wzqvip/ESP32S3-SX1262-Meshtatics-Station/Datasheet/module_pics/ATGM336H 5N.png

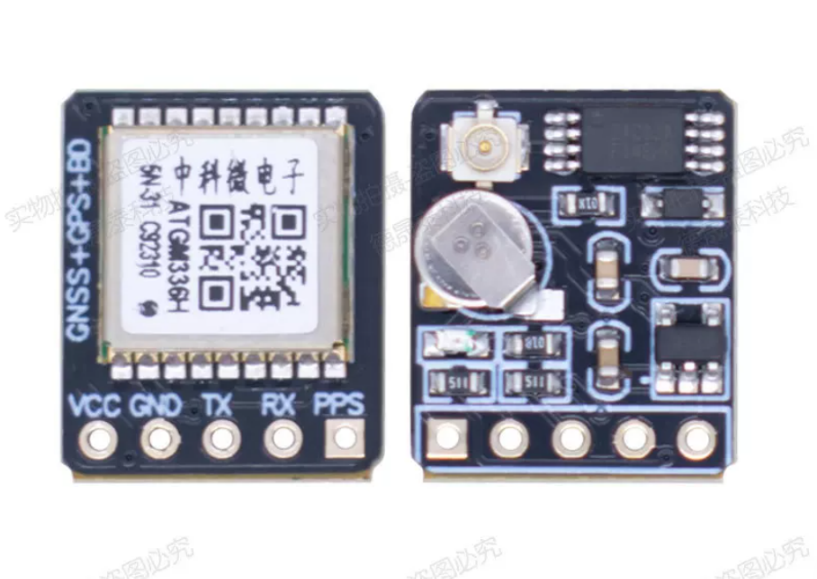
Datasheet/module_pics/ATGM336H 5N.png
