wzqvip/ESP32S3-SX1262-Meshtatics-Station/Datasheet/module_pics/BMI160.webp

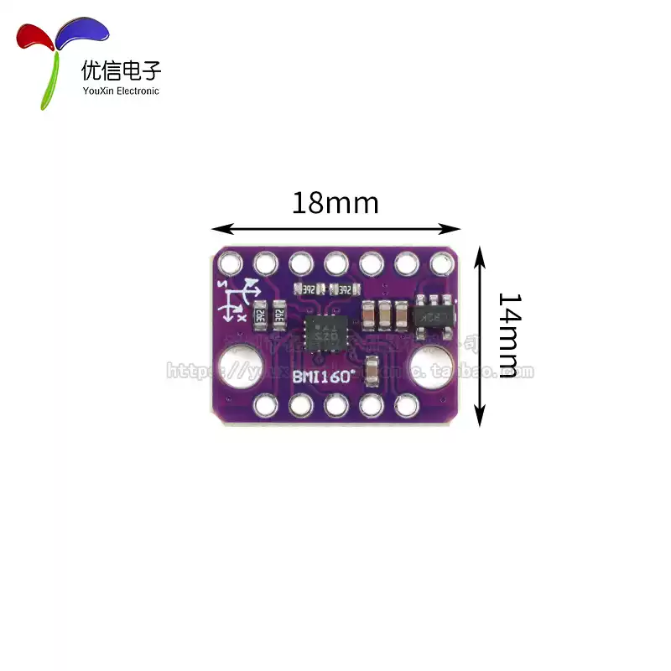
Datasheet/module_pics/BMI160.webp
