wzqvip/ESP32S3-SX1262-Meshtatics-Station/Datasheet/module_pics/DC-DC MP2482 SY8205 5A.webp

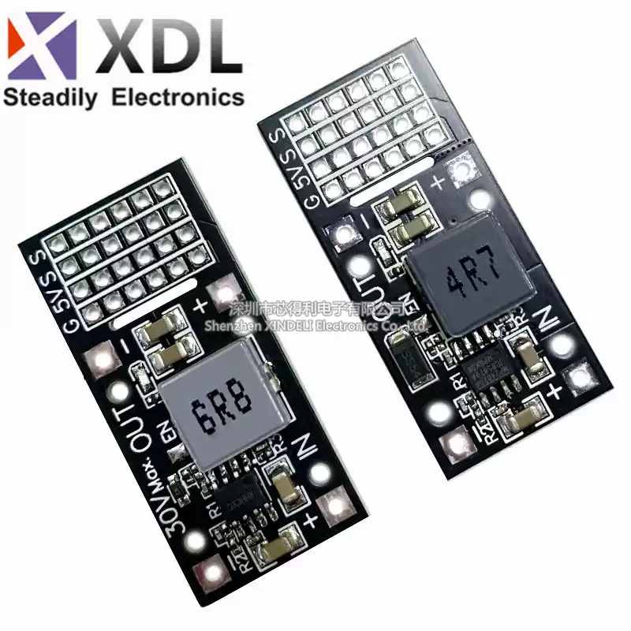
Datasheet/module_pics/DC-DC MP2482 SY8205 5A.webp
