wzqvip/ESP32S3-SX1262-Meshtatics-Station/Datasheet/module_pics/E22-900M30S.webp

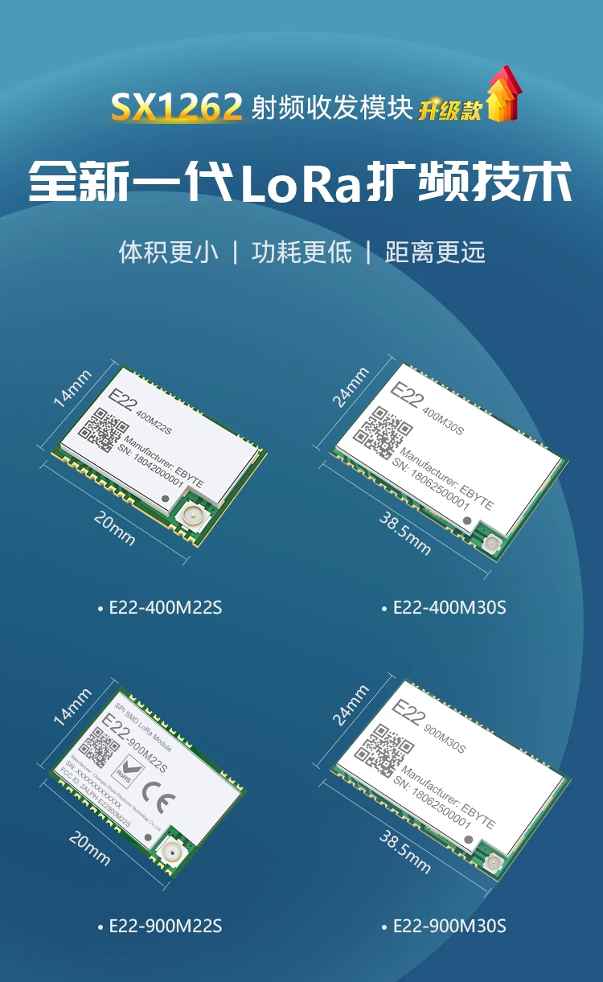
Datasheet/module_pics/E22-900M30S.webp
