wzqvip/ESP32S3-SX1262-Meshtatics-Station/Datasheet/module_pics/ESP32-S3-Pico-details-size.jpg

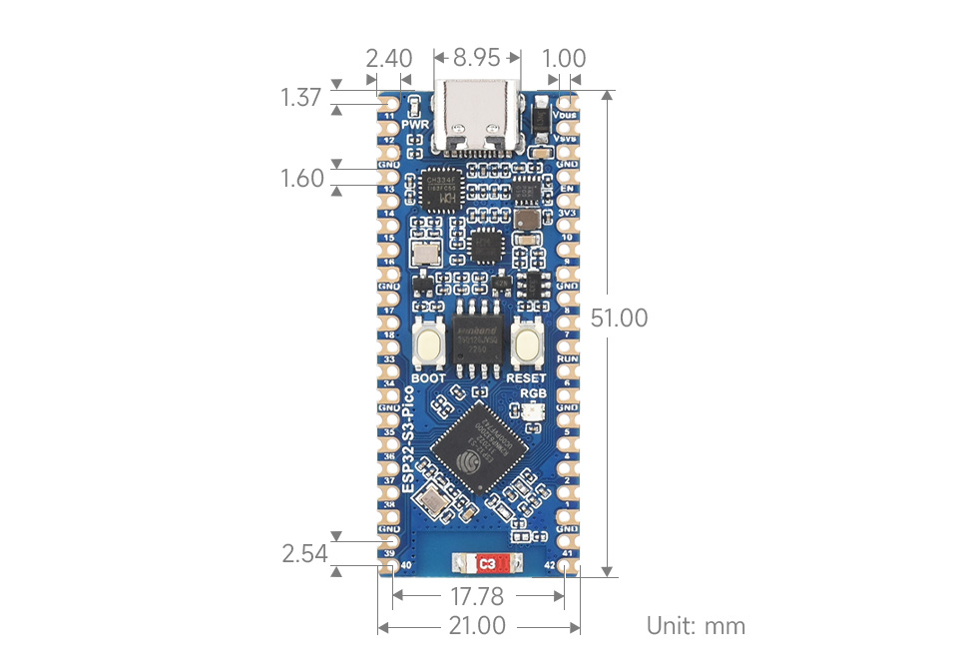
Datasheet/module_pics/ESP32-S3-Pico-details-size.jpg
