wzqvip/ESP32S3-SX1262-Meshtatics-Station/Datasheet/module_pics/OLED_12864.webp

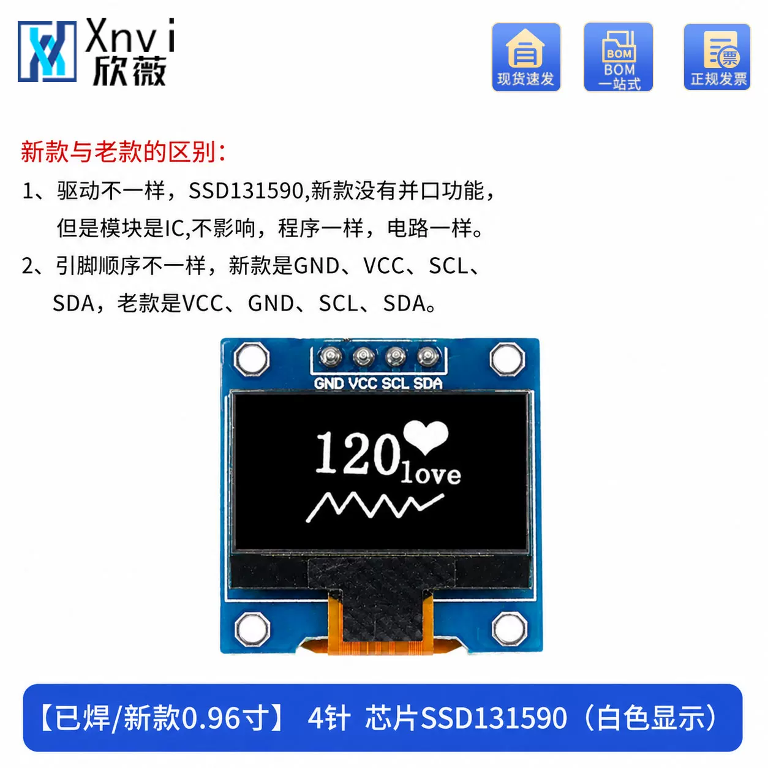
Datasheet/module_pics/OLED_12864.webp
