wzqvip/ESP32S3-SX1262-Meshtatics-Station/Datasheet/module_pics/PCF8563.webp

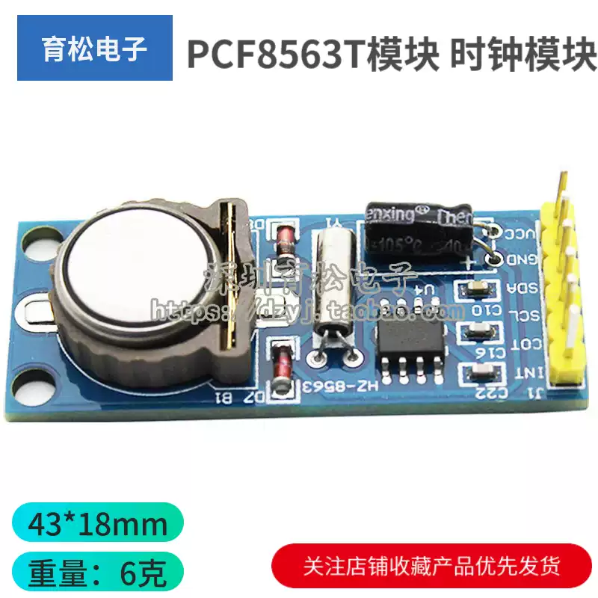
Datasheet/module_pics/PCF8563.webp
