wzqvip/ESP32S3-SX1262-Meshtatics-Station/PD-DC.png

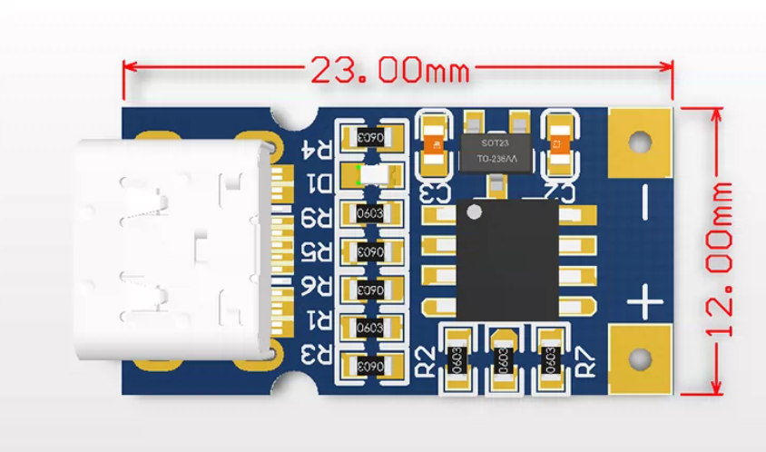
PD-DC.png
