wzqvip/ESP32S3-SX1262-Meshtatics-Station/Review/hardware-schematic/pico-clone-flash-chip.png

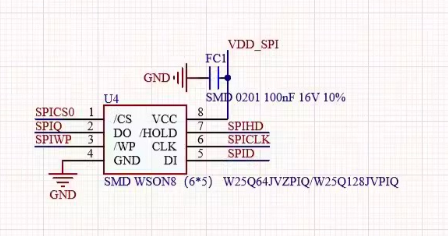
Review/hardware-schematic/pico-clone-flash-chip.png
