wzqvip/ESP32S3-SX1262-Meshtatics-Station/Review/hardware-schematic/pico-clone-full-schematic.jpg

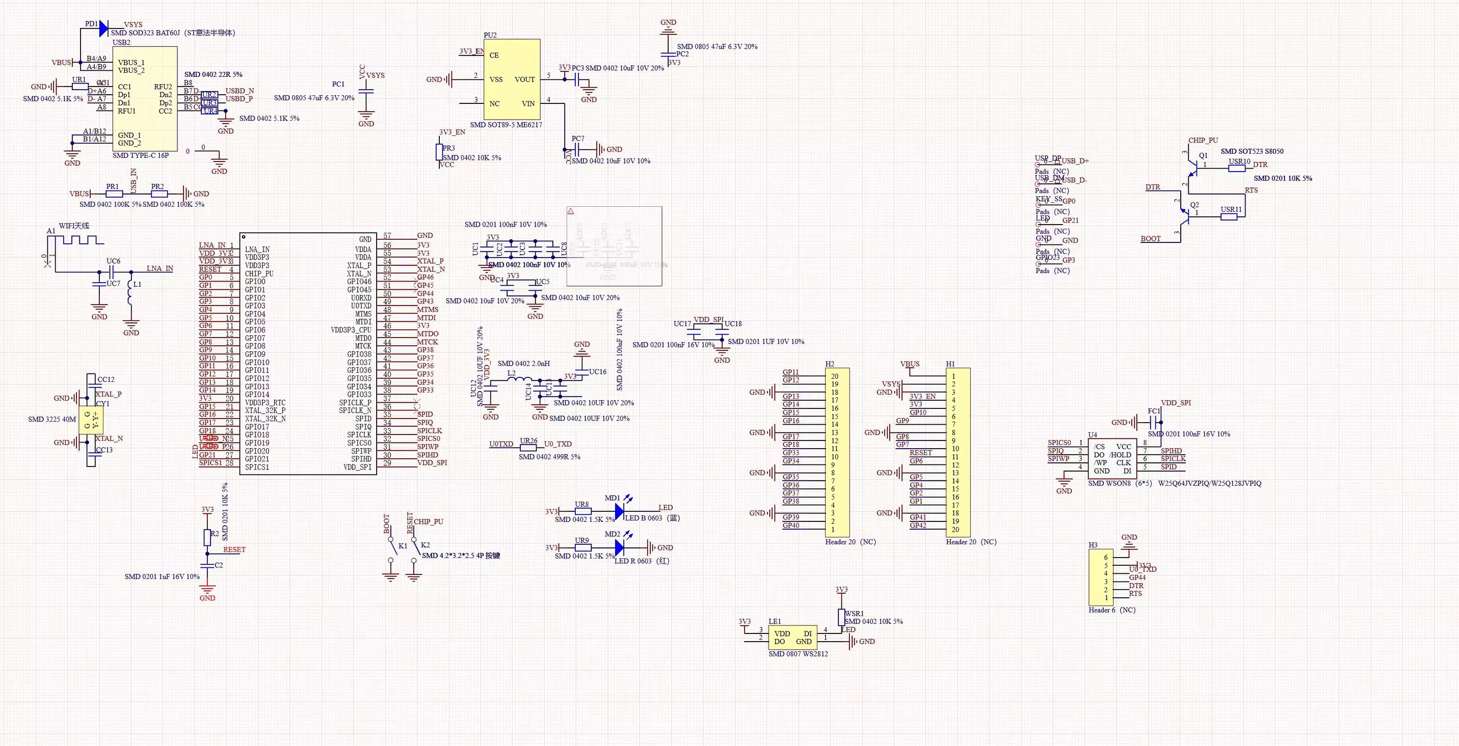
Review/hardware-schematic/pico-clone-full-schematic.jpg
