wzqvip/ESP32S3-SX1262-Meshtatics-Station/PCB/3D_PCB1_1_2026-10-14.step

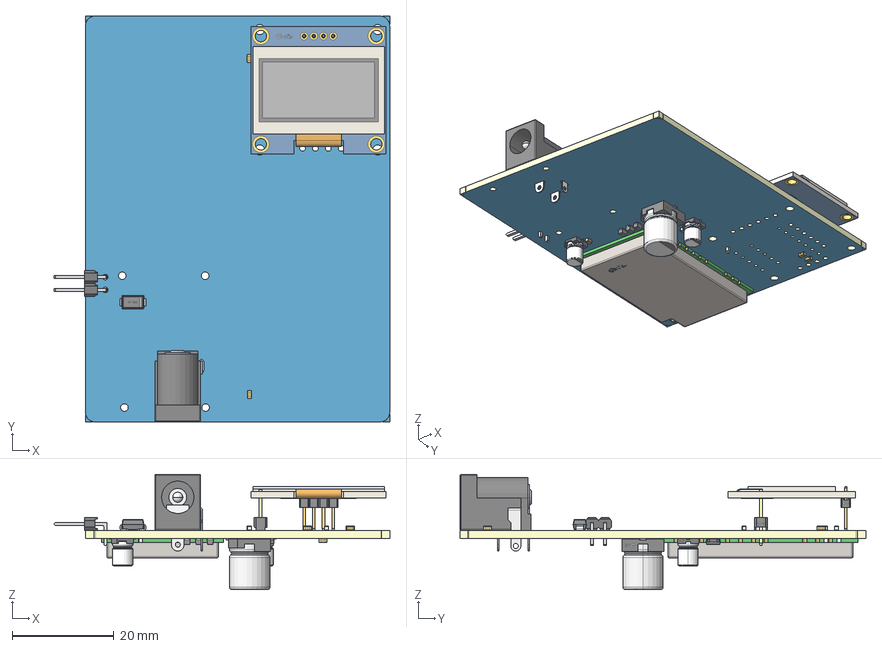
[picture p15: CAD file, 2026-10-14]
PCB/3D_PCB1_1_2026-10-14.step
66.1 x 80.0 x 22.7 mm
Board~G7O5
TopCopper~G7O5
BottomCopper~G7O5
TopSilkscreen~G7O5
BottomSilkscreen~G7O5
TopFpcStiffener~G7O5
BottomFpcStiffener~G7O5
C0603~C0603_L1.6-W0.8-H0.8~G7O5 x 9
SOT-23-5_L3.0-W1.7-P0.95-LS2.8-BR~SOT-23-5_ L2.9-W1.6-H1.1-LS2.8-P0.95~G7O5
DC-IN-TH_DC-005-A200~DC-IN-TH_DC-005-A200~G7O5
SMA_L4.3-W2.6-LS5.0-FD~SMA_L4.3-W2.6-LS5.0-FD~G7O5
CAP-SMD_BD4.0-L4.3-W4.3-LS5.0-FD~CAP-SMD_L4.3-W4.3-H5.3-LS5.1~G7O5 x 2
CAP-SMD_L2.0-W1.3-FD~CAP-SMD_L2.0-W1.3-FD~G7O5 x 3
HDR-TH_2P-P2.54-H-M-W10.0~HDR-TH_2P-P2.54-M-WI-1X2P~G7O5
WIRELM-SMD_E22-900M30S~WIRELM-SMD_L38.5-W24.0-H3.9-E22-900M30S~G7O5
CAP-SMD_BD8.0-L8.3-W8.3-LS9.3-FD~CAP-SMD_BD8.0-L8.3-W8.3-LS9.3-FD~G7O5
OLED 0.96寸~OLED4P~G7O5 x 2
HDR-TH_1P-P2.54-V-M-3~HDR-TH_1P-P2.54-V-M-3~G7O5
