wzqvip/ESP32S3-SX1262-Meshtatics-Station/PCB/SCH_Schematic1_1_2026-10-14.pdf

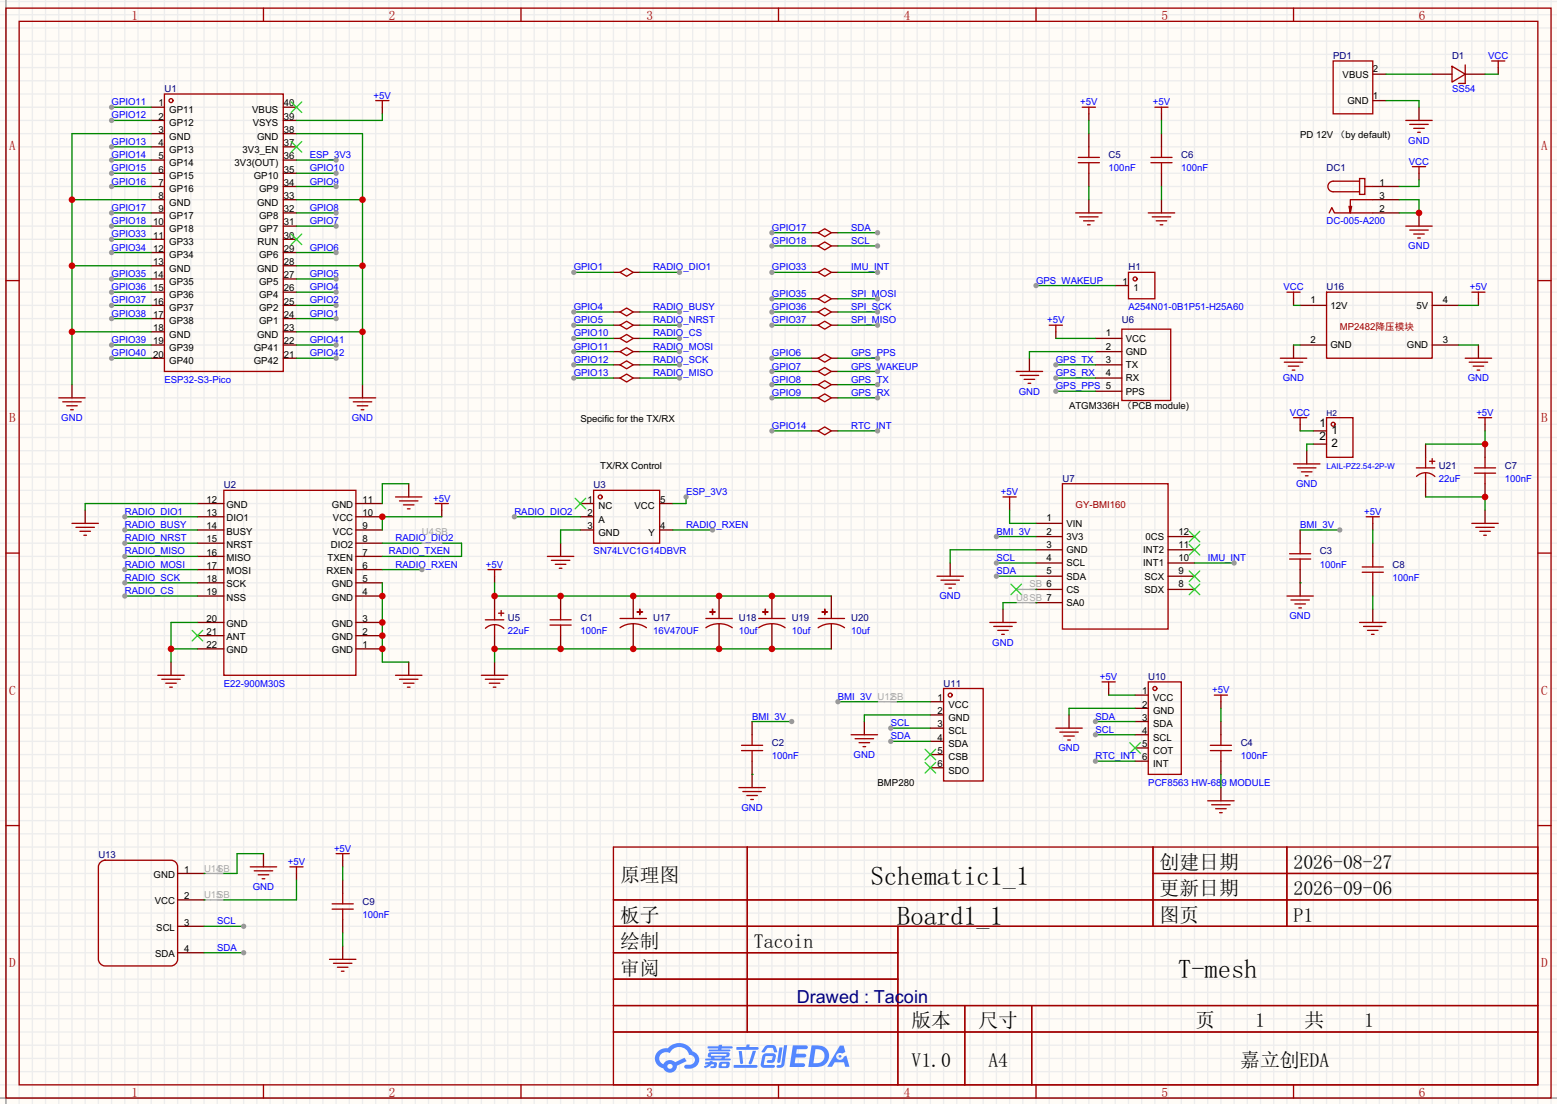
[picture p16: page 1]

PD1 | | D1 | VCC
VBUS 2

GPIO11 | GP11 1 | | +5V | +5V | | | GND 1
GPIO12 | GP12 2

U1 | +5V | | | | | | SS54
GP40 20 GND 8 | GP42 | 21 GP41 22 GND 23 GP1 24 GP2 25 GP4 26 GP5 27 GND 28 GP6 29 RUN 30 GP7 31 GP8 32 GND 33 GP9 34 GP10 35 3V3(OUT) 36 3V3_EN 37 GND 38 VSYS 39 VBUS 40 | | | | | | | 3

GND 3 | | | | PD 12V （by default)

A | GPIO13 | GP13 4 | | | | | | | | | | GND | | A

GPIO14 | GP14 5 | | | ESP_3V3 | | | C5 | C6 | | | | VCC
GPIO15 | GP15 6 | | | GPIO10 | | | 100nF | 100nF | DC1
GPIO16 | GP16 7 | | | GPIO9 | | | | | | 1

GPIO17 | GP17 9 | | | GPIO8 | | | | | | 2
GPIO18 | GP18 10 | | | GPIO7 | GPIO17 | SDA | | | DC-005-A200
GPIO33 | GP33 11
GPIO34 | GP34 12 | | | GPIO6 | GPIO18 | SCL | | | | | | GND

GND 13 | | GPIO1 | RADIO_DIO1 | GPIO33 | IMU_INT | | | | H1

GPIO35 | GP35 14 | GPIO5 | | | | | GPS_WAKEUP
GPIO36 | GP36 15 | GPIO4 | | | GPIO35 | SPI_MOSI | | | 1 | 1 | VCC | U16 | | | | | +5V
GPIO37 | GP37 16 | GPIO2 | | | | | | | | | | 12V 1 | | | 5V | 4
GPIO38 | GP38 17 | GPIO1 | GPIO4 | RADIO_BUSY RADIO_NRST | GPIO36 | SPI_SCK | | +5V | U6 | A254N01-0B1P51-H25A60

GPIO5 | | GPIO37 | SPI_MISO
GPIO10 | RADIO_CS
GPIO11
GPIO12 | RADIO_SCK

GPIO39 | GP39 19 | GPIO41 | | RADIO_MOSI | | | | | | VCC 1 | | GND 2 | | GND | | 3
GPIO40 | | GPIO42 | | | GPIO6 | GPS_PPS | | GPS_TX | | GND 2

GND 18 | | | | | | | | | | | | MP2482降压模块

GPIO7 | GPS_WAKEUP | | | | TX 3

ESP32-S3-Pico | | GPIO13 | RADIO_MISO | GPIO8 | GPS_TX | | GPS_RX GPS_PPS | | RX 4 | GND | | | | | | GND

GPIO9 | GPS_RX | GND | | PPS 5

ATGM336H （PCB module) | | VCC | | | | +5V

B | GND | GND | | GPIO14 Specific for the TX/RX | RTC_INT | | | | | 1 | H2 | | | | B

TX/RX Control | | | | | | | | | U21 | | C7

U7 | | | LAIL-PZ2.54-2P-W | | 22uF | 100nF

U2 | | | | | | U3 | | | | ESP_3V3 | +5V | | | GND
GND | | 11 GND 12 | +5V | | | NC 1 | VCC | 5

RADIO_DIO1 | DIO1 13 | | VCC | 10 | | RADIO_DIO2 | 2 | | | | | | | GY-BMI160 | | | +5V

RADIO_NRST | | NRST 15 | | DIO2 | | 8 | RADIO_DIO2 | | | | | | | Y | | | | | | | | | | | 3V3 2 | 0CS | 12
RADIO_MISO | | MISO 16 | | TXEN | | 7 | RADIO_TXEN | | | | | SN74LVC1G14DBVR | | | | | | | | | | | | | GND 3 | INT2 | 11 | IMU_INT | | C3
RADIO_MOSI | | MOSI 17 | | RXEN | | 6 | RADIO_RXEN | +5V | | | | | | | | | | | | | | | | | SCL 4 | INT1 | 10 | | | 100nF | C8
RADIO_SCK | | SCK 18 | | GND | | 5 | | | | | | | | | | | | | | | | | SDA | | SDA 5 | SCX | 9 | | | | 100nF
RADIO_CS | | NSS 19 | | GND | | 4 | | | | | | | | | | | | | | | | GND | | | CS 6 | SDX | 8

SCL

SB
SA0 7

GND 20 | | GND | | 3 | | | U5 | | C1 | | | | U17 | | U18 | | U19 | | U20 | | | | | | | | GND
ANT 21 | | GND | | 2 | | | 22uF | | 100nF | | | 16V470UF | | | 10uf | | 10uf | | 10uf
GND 22 | | GND | | 1 | | | | | | | | | | | | | | | | | GND

BMI_3V | | U12SB | | VCC 1 | | | | VCC 1

BMI_3V | | | | | | GND 2 | | | | GND 2

SDA

C2 | | | | SDA | SDA 4 | | | | SCL 4 | | C4
100nF | | GND | | | CSB 5 | GND | RTC_INT | | COT 5 | | 100nF

SCL | SCL 3 | | SCL | | SDA 3

SDO 6 | | | | INT 6

BMP280 | | | | | PCF8563 HW-689 MODULE

U13 | | | | | +5V
GND | 1 | U14SB | | | | 原理图 | Schematic1_1 | 创建日期 | 2026-08-27

GND | | | | | 更新日期 | 2026-09-06

VCC | 2 | U15SB

C9 100nF | 板子 | | Board1_1 | 图页 | P1

SCL | 3 | | SCL

绘制 | Tacoin

SDA | 4 | SDA

D | | | | 审阅 | T-mesh | D

Drawed : Tacoin
