wzqvip/ESP32S3-SX1262-Meshtatics-Station/PCB/SCH_Schematic1_1_2026-09-06.pdf

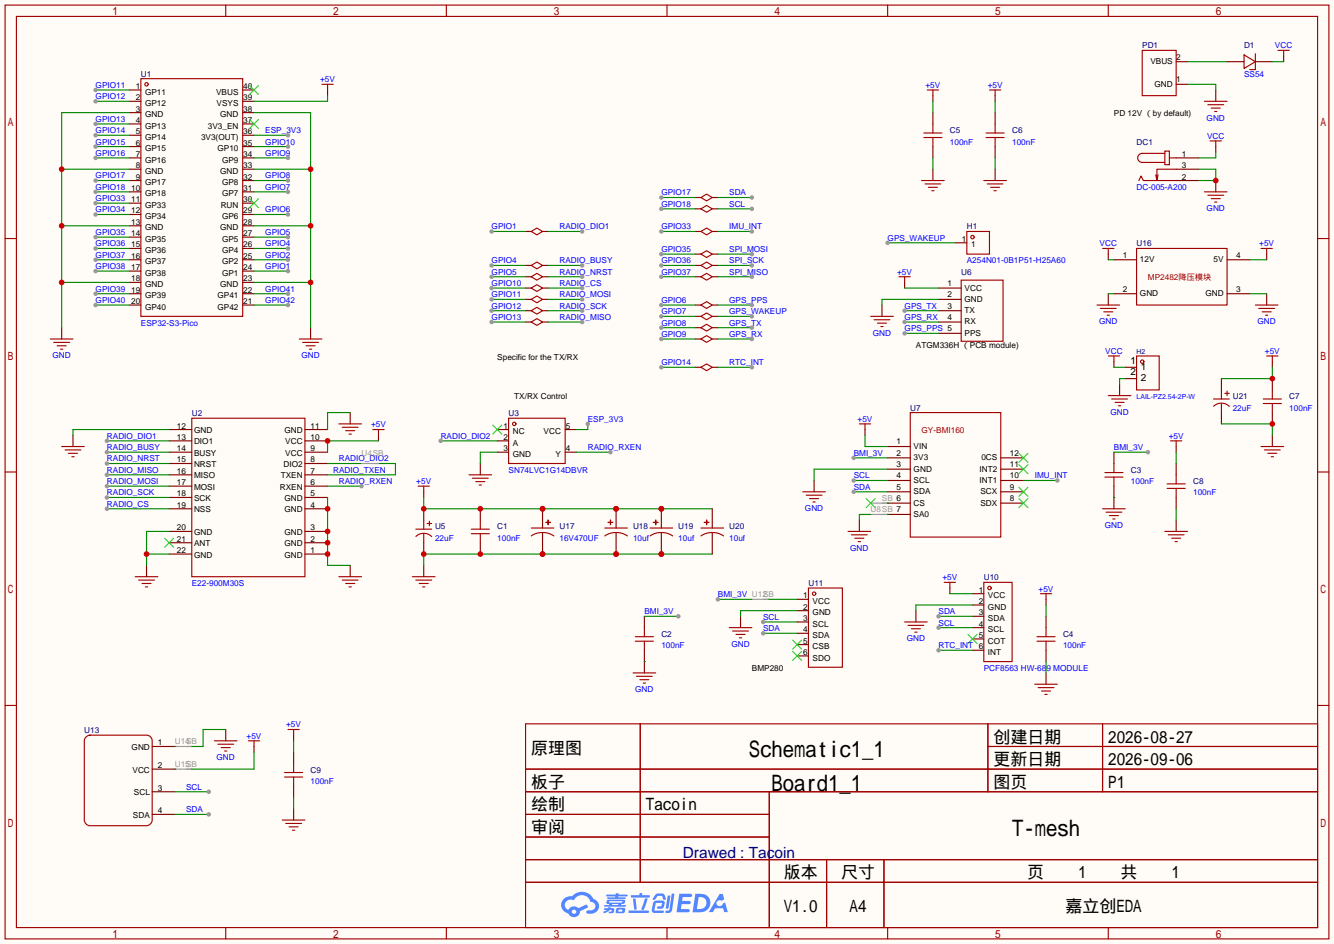
[picture p17: page 1]

GPIO14 Specific for the TX/RX

原理图 | Schematic1_1 | 创建日期 | 2026-08-27
板子 | Board1_1 | 图页 | P1
绘制 | Tacoin | T-mesh
审阅

更新日期 | 2026-09-06

Drawed : Tacoin

V1.0 | A4 | 嘉立创EDA
