wzqvip/ESP32S3-SX1262-Meshtatics-Station/nano_g1_explorer_06_mar_2023.pdf

Battery Charger | Buck-Boost Converter 100k R8 100k R9 GND | BAT_ADC BAT

# Type C / Battery

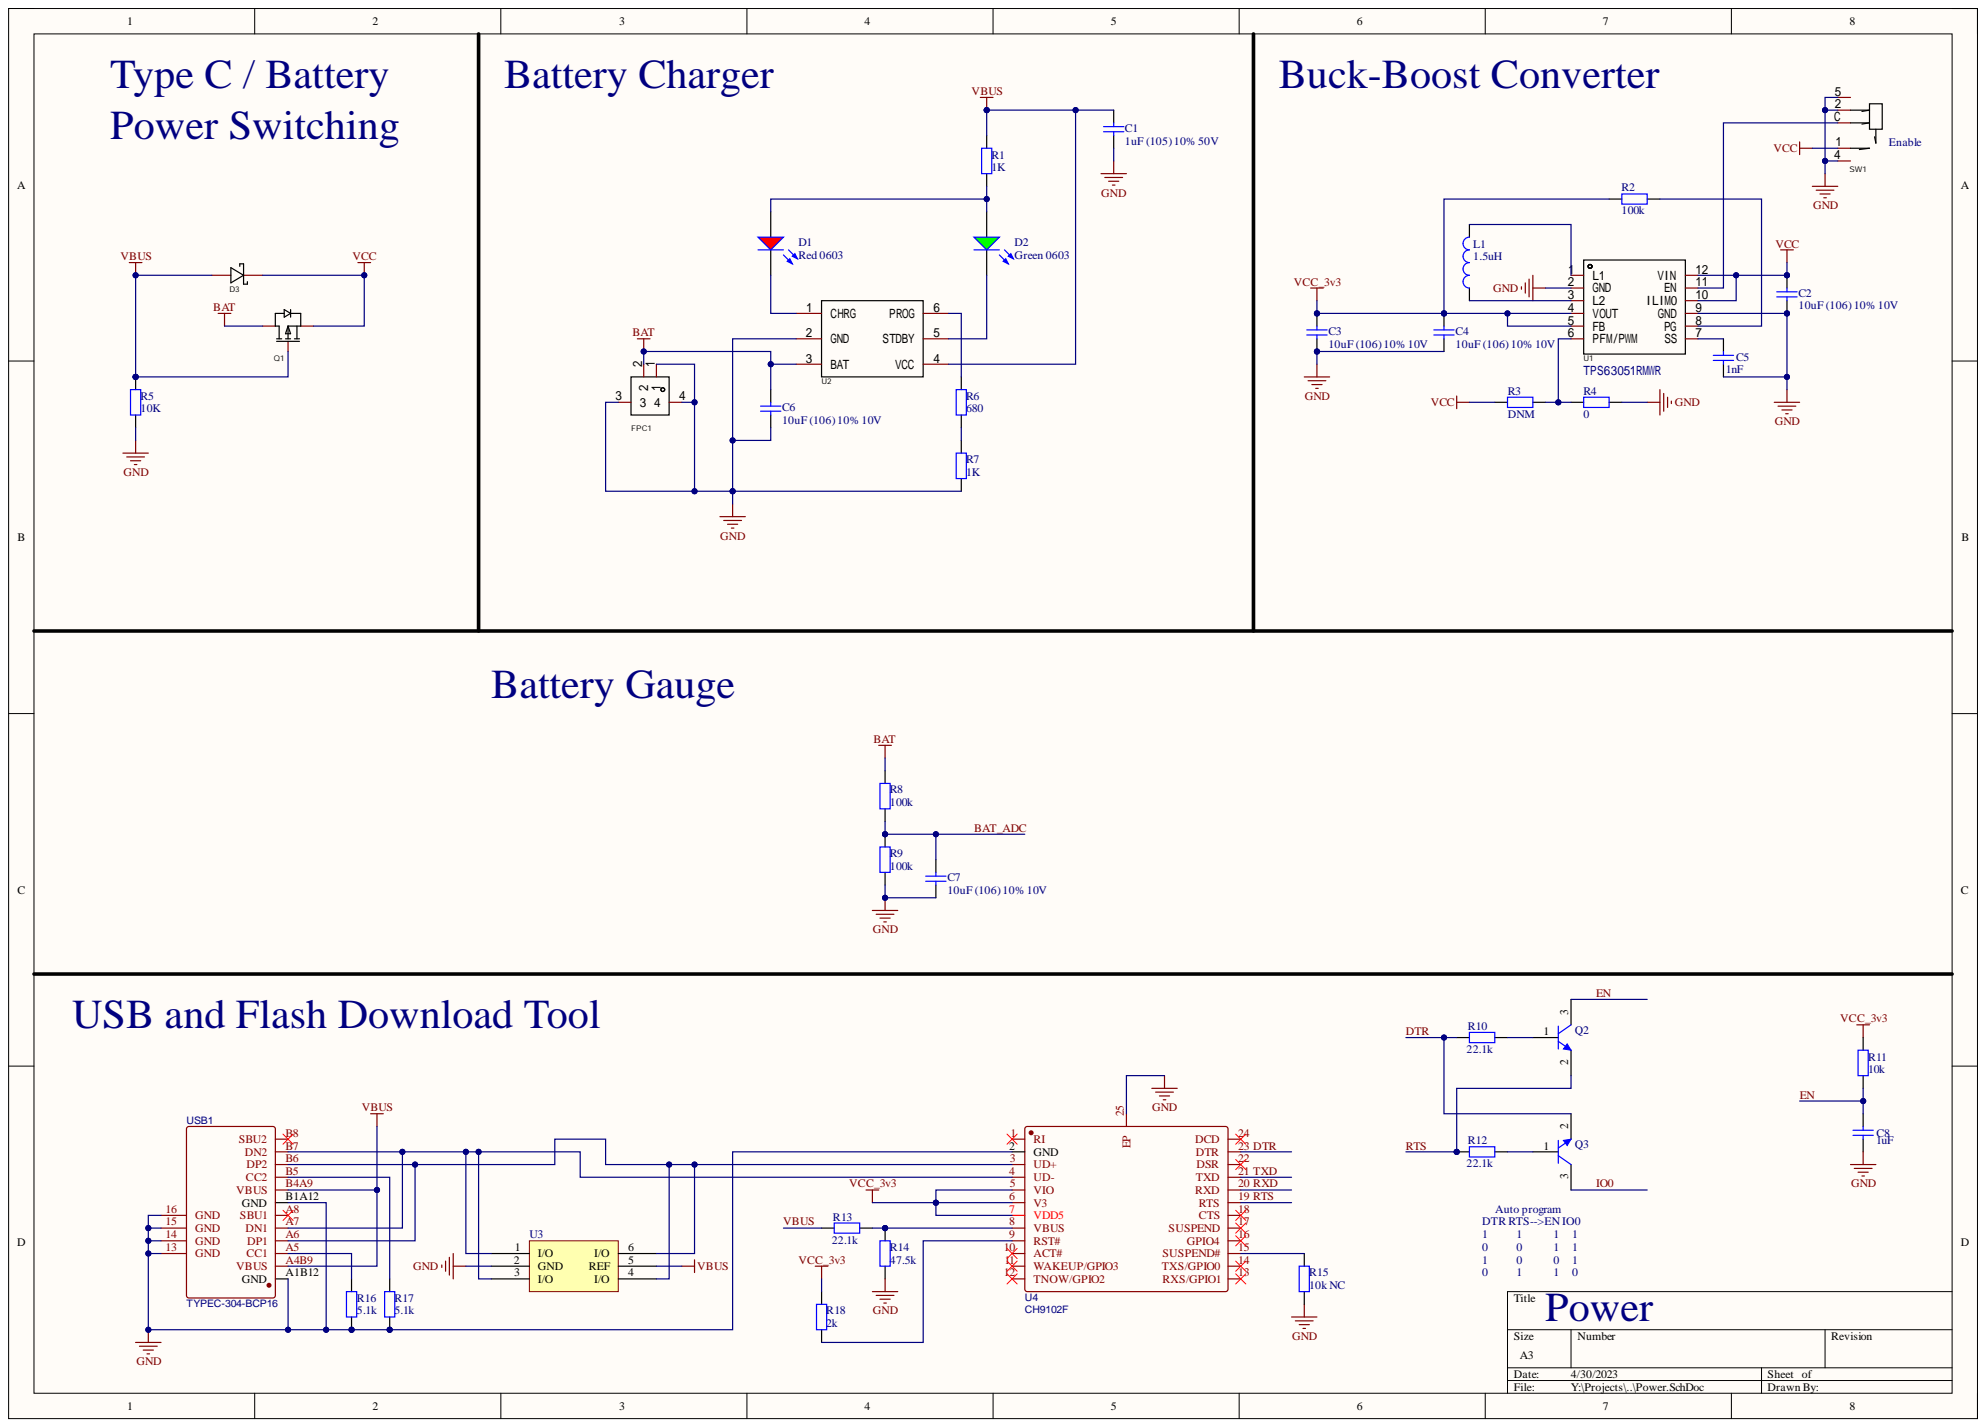
[picture p18: page 1]
ENIO0; XD RXD RTS; END; PEND; Tool; Power Switching; Battery Gauge; Power

USB and Flash Download

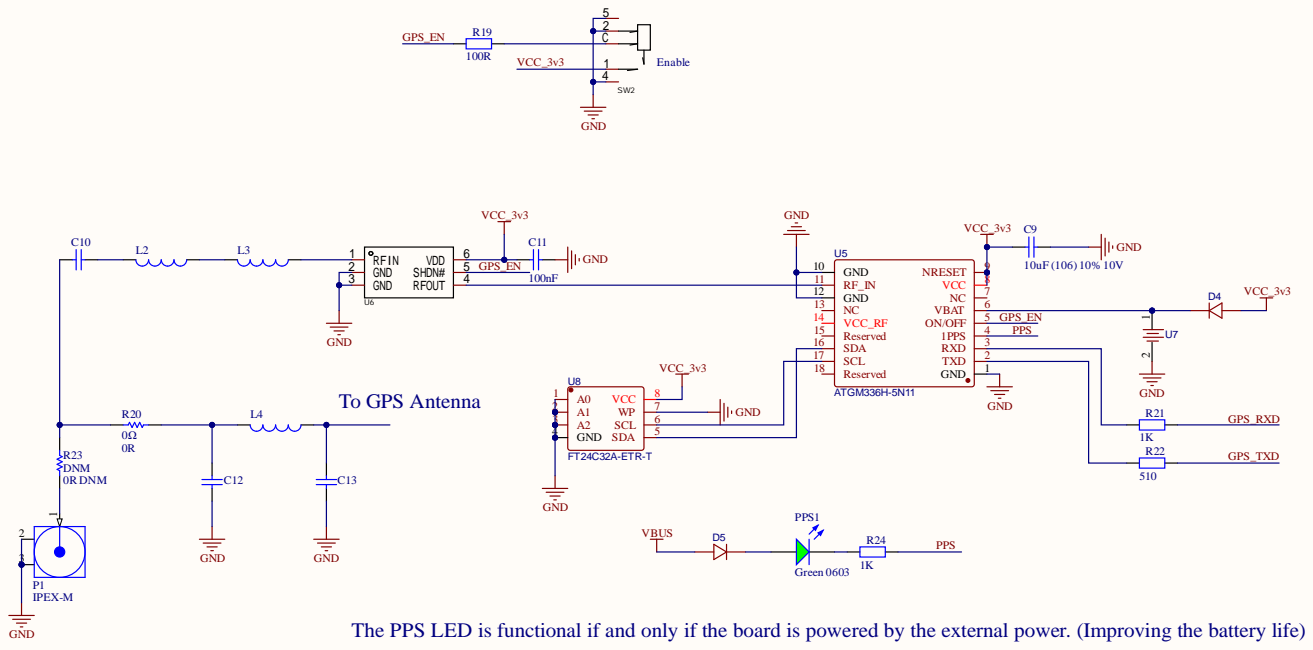
[picture p19: page 2]

The PPS LED is functional if and only if the board is powered by the external power. (Improving the battery life)

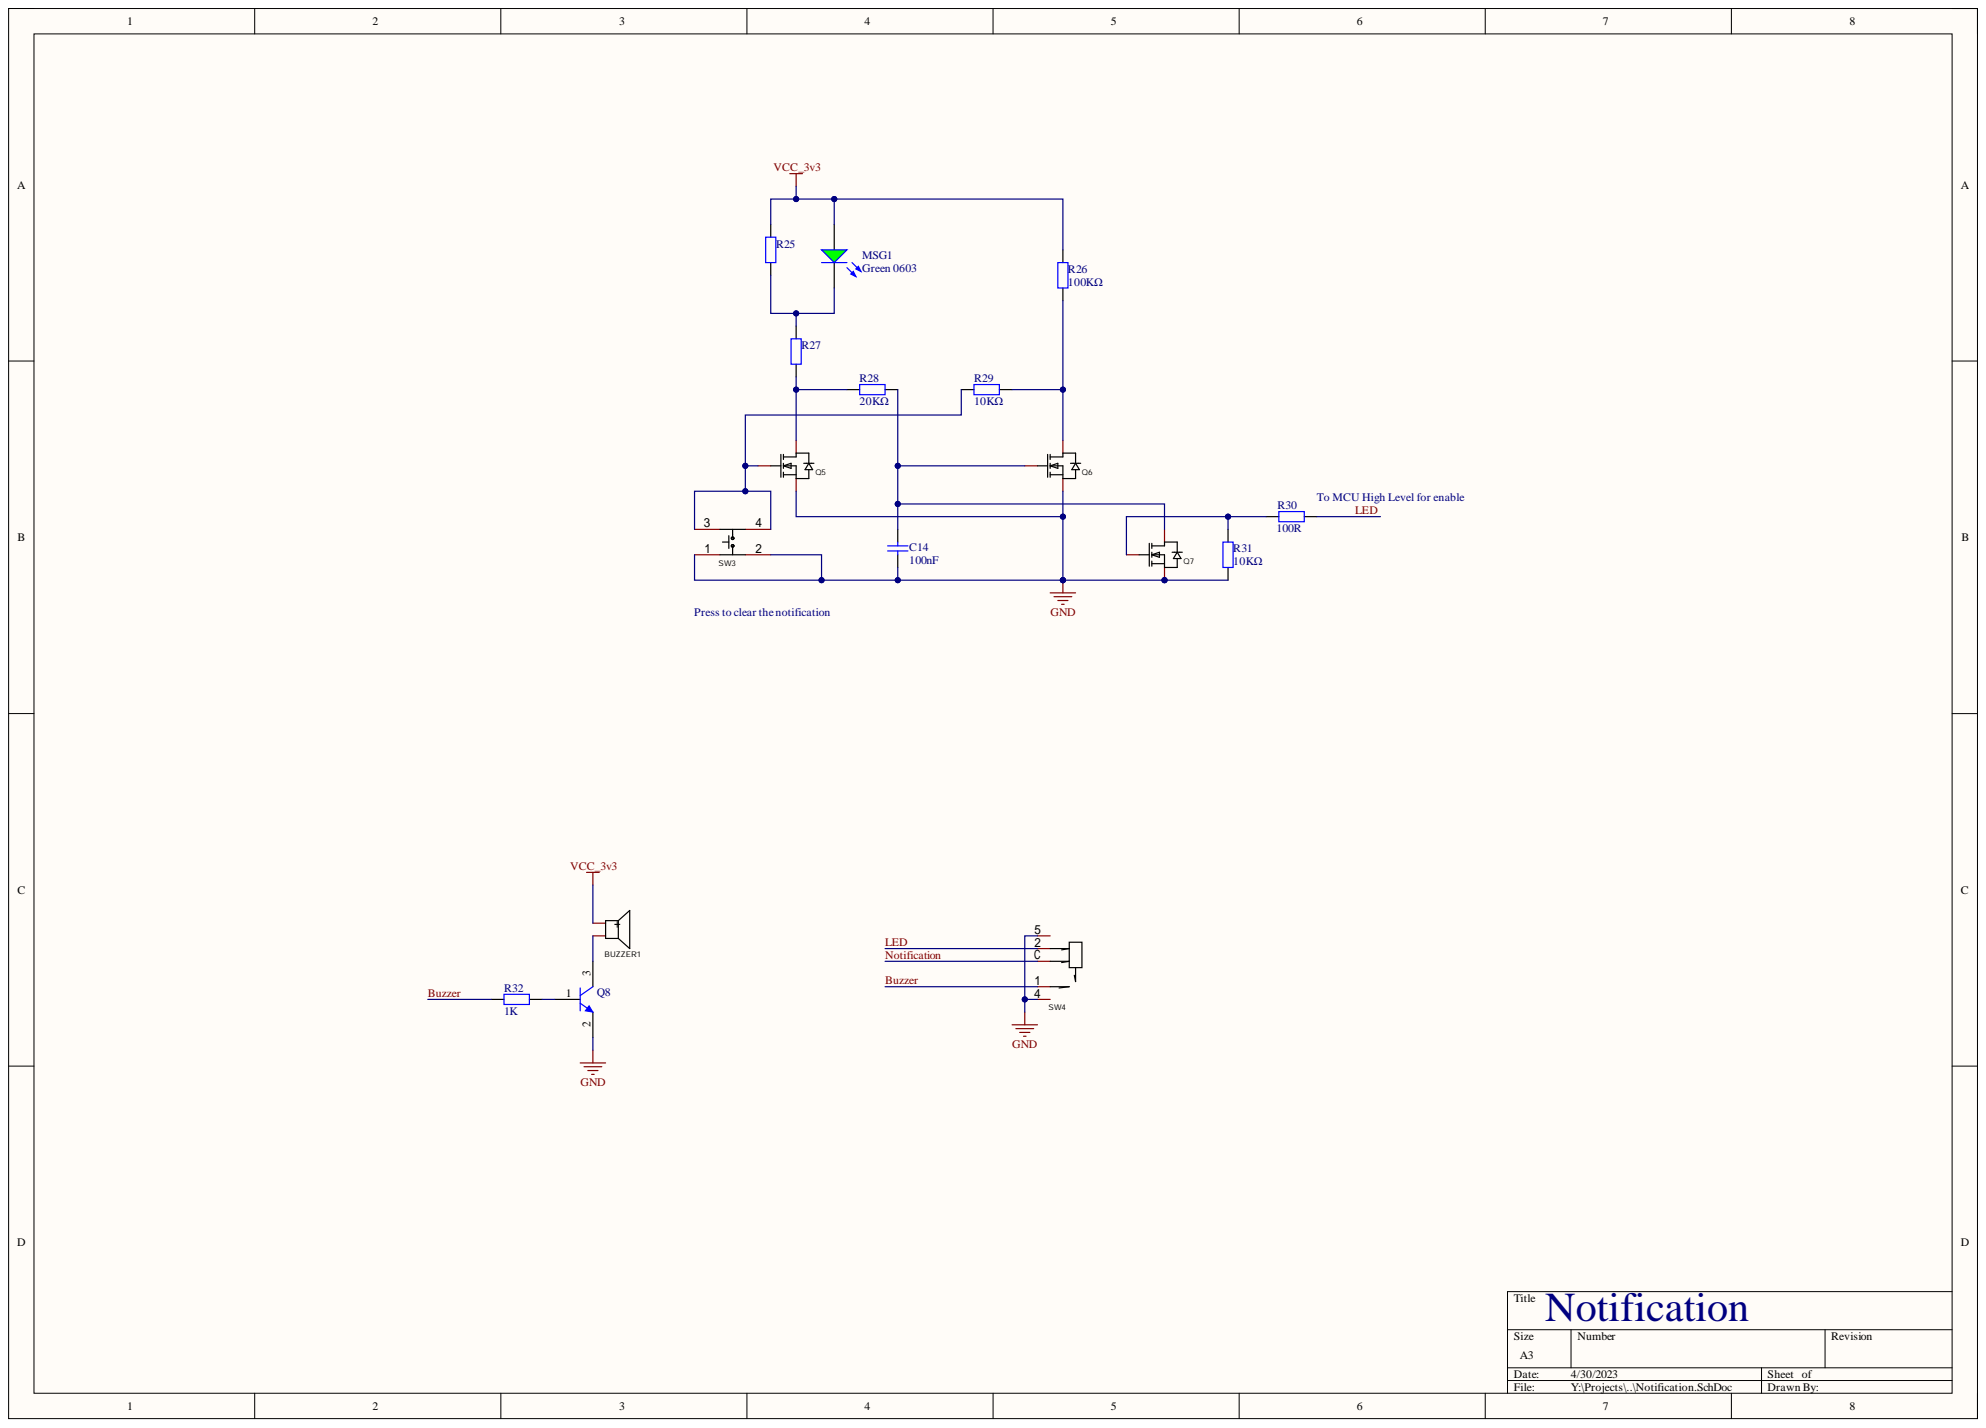
[picture p20: page 3]

To MCU High Level for enable

Pressto clear the notification

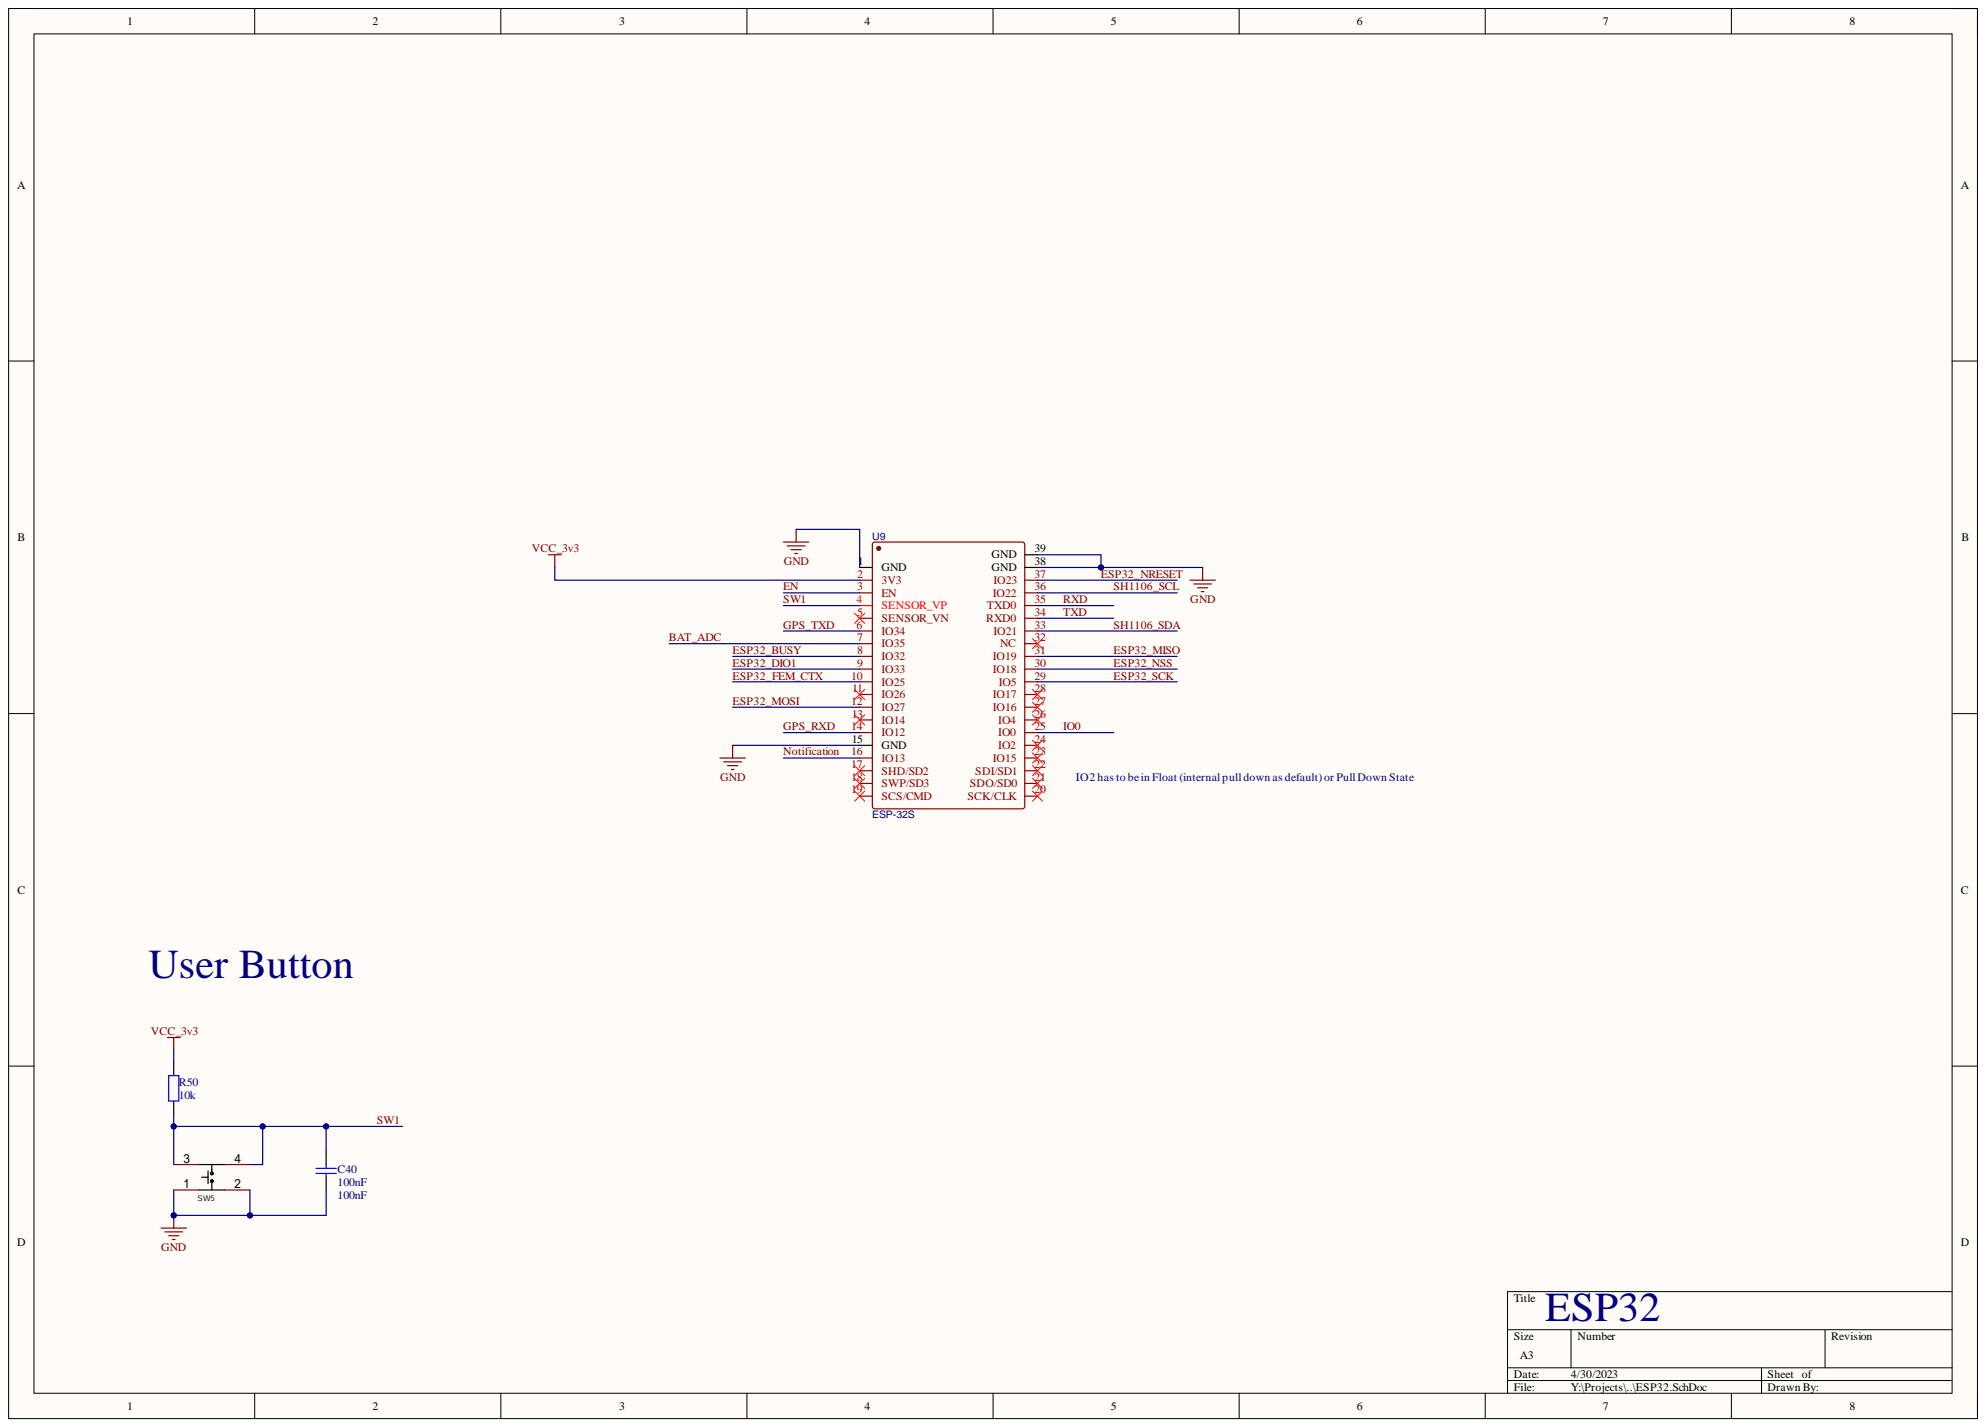
[picture p21: page 4]
Title; Size; Number; Revision; File:; Y:\Projects\..\ESP32.SchDoc; Drawn By:; GND 1 3V3 2 EN 3 SENSOR_VP 4 SENSOR_VN 5 IO34 6 IO35 7 IO32 8 IO33 9 IO25 10 IO26 11 IO27 12 IO14 13 IO12 14 GND 15 IO13 16 SHD/SD2 17 SWP/SD3 18; SCS/CMD 19; SCK/CLK; 20 SDO/SD0; 21 SDI/SD1; 33 RXD0; 34 TXD0; 37 GND; 38 GND; ESP-32S; TXD; RXD; GND; VCC_3v3; SH1106_SDA; SH1106_SCL; Notification; GPS_RXD; GPS_TXD; BAT_ADC; ESP32_MOSI; ESP32_FEM_CTX; ESP32_DIO1; ESP32_BUSY; User Button; ESP32_SCK; ESP32_NSS; ESP32_MISO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

IO2 hasto be in Float (internal pull down as default) or PullDown State

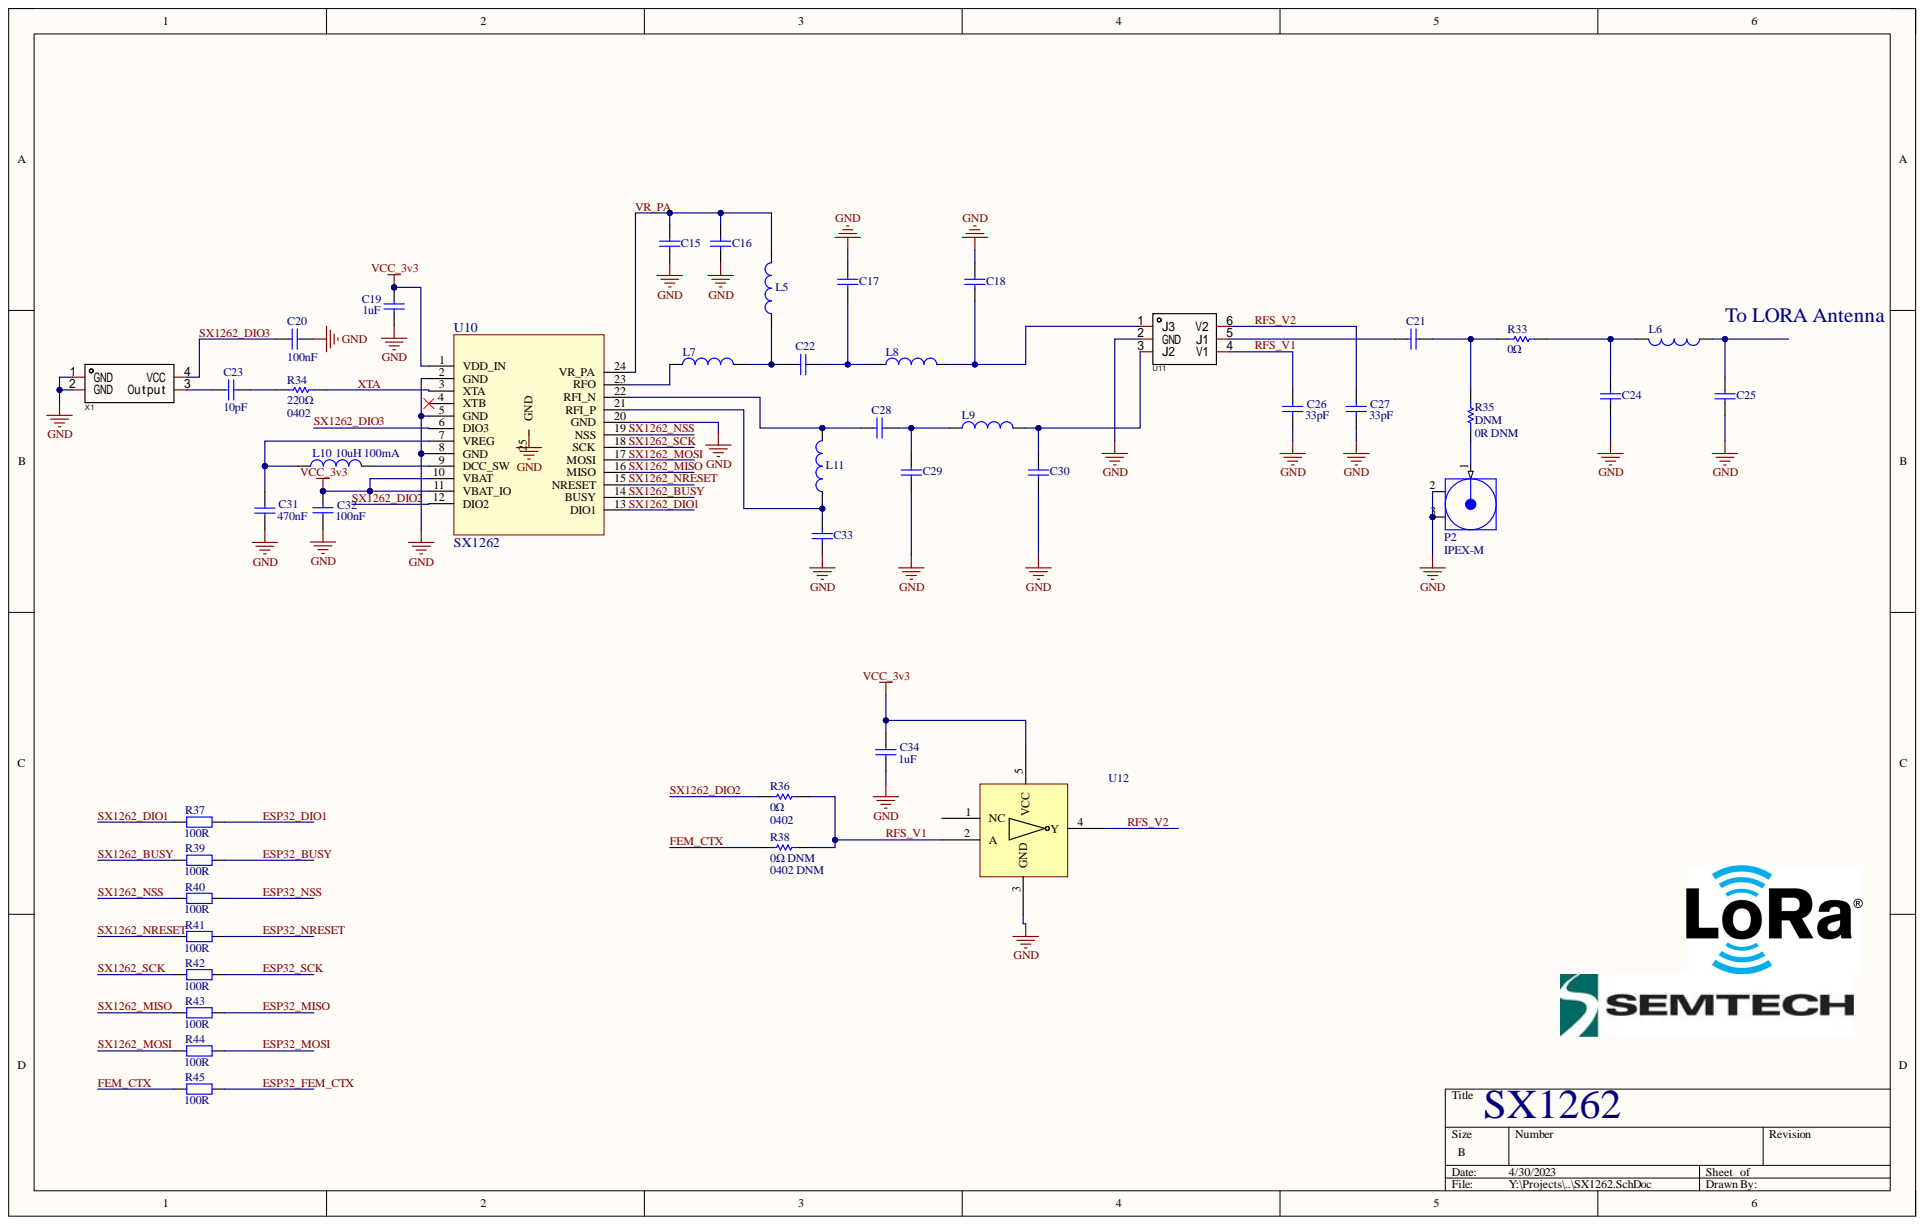
[picture p22: page 5]

A | A

## VCC_3v3

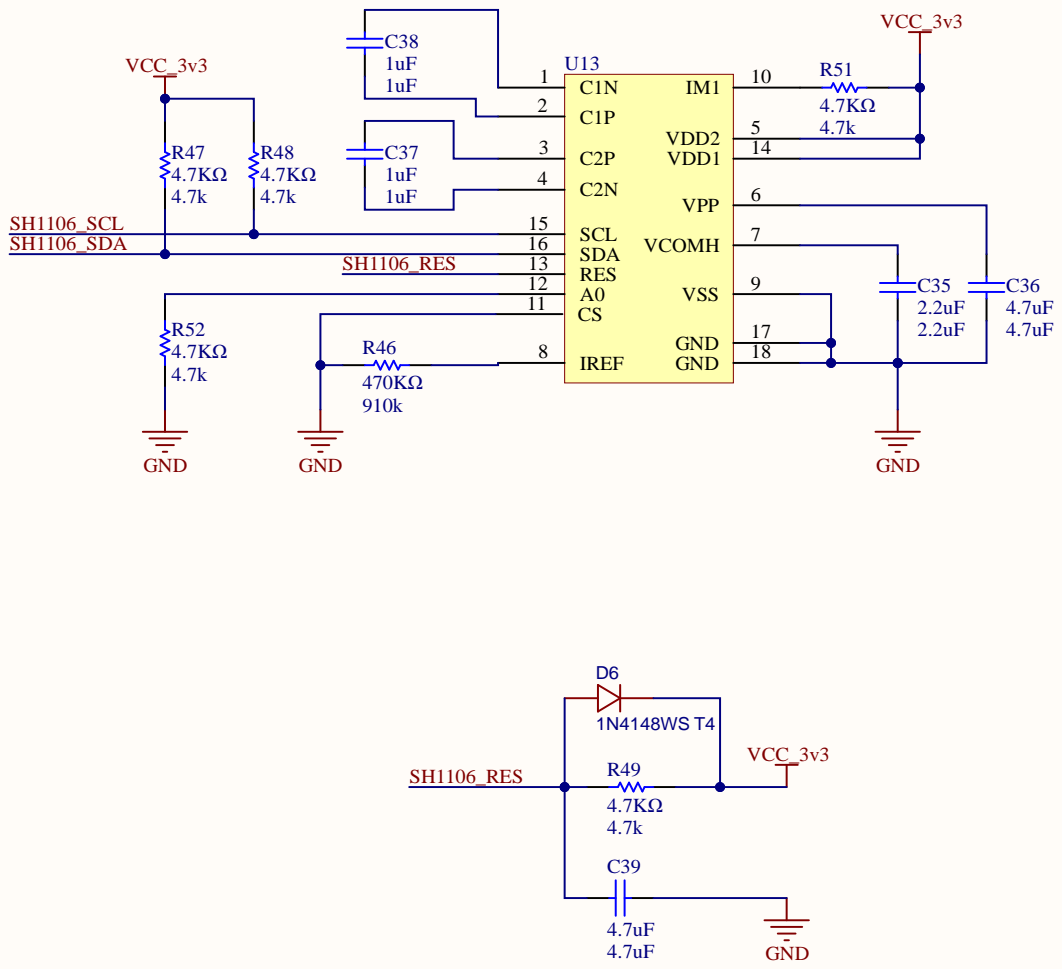
[picture p23: page 6]
