wzqvip/ESP32S3-SX1262-Meshtatics-Station/PCB/PCB_PCB1_1_2026-10-14.pdf

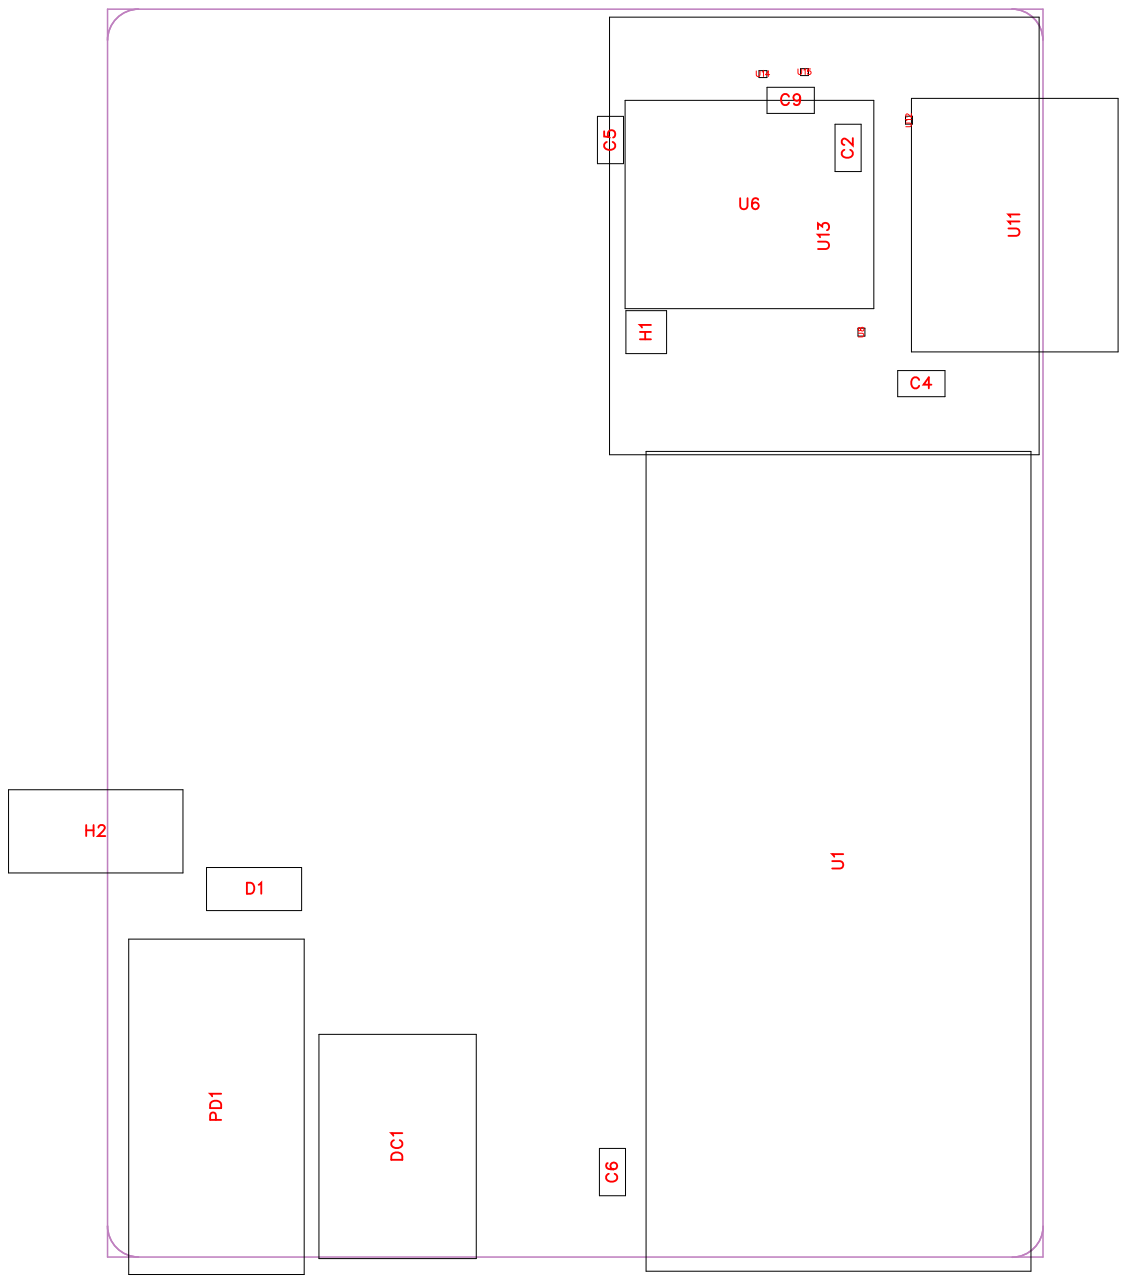
[picture p24: page 1]

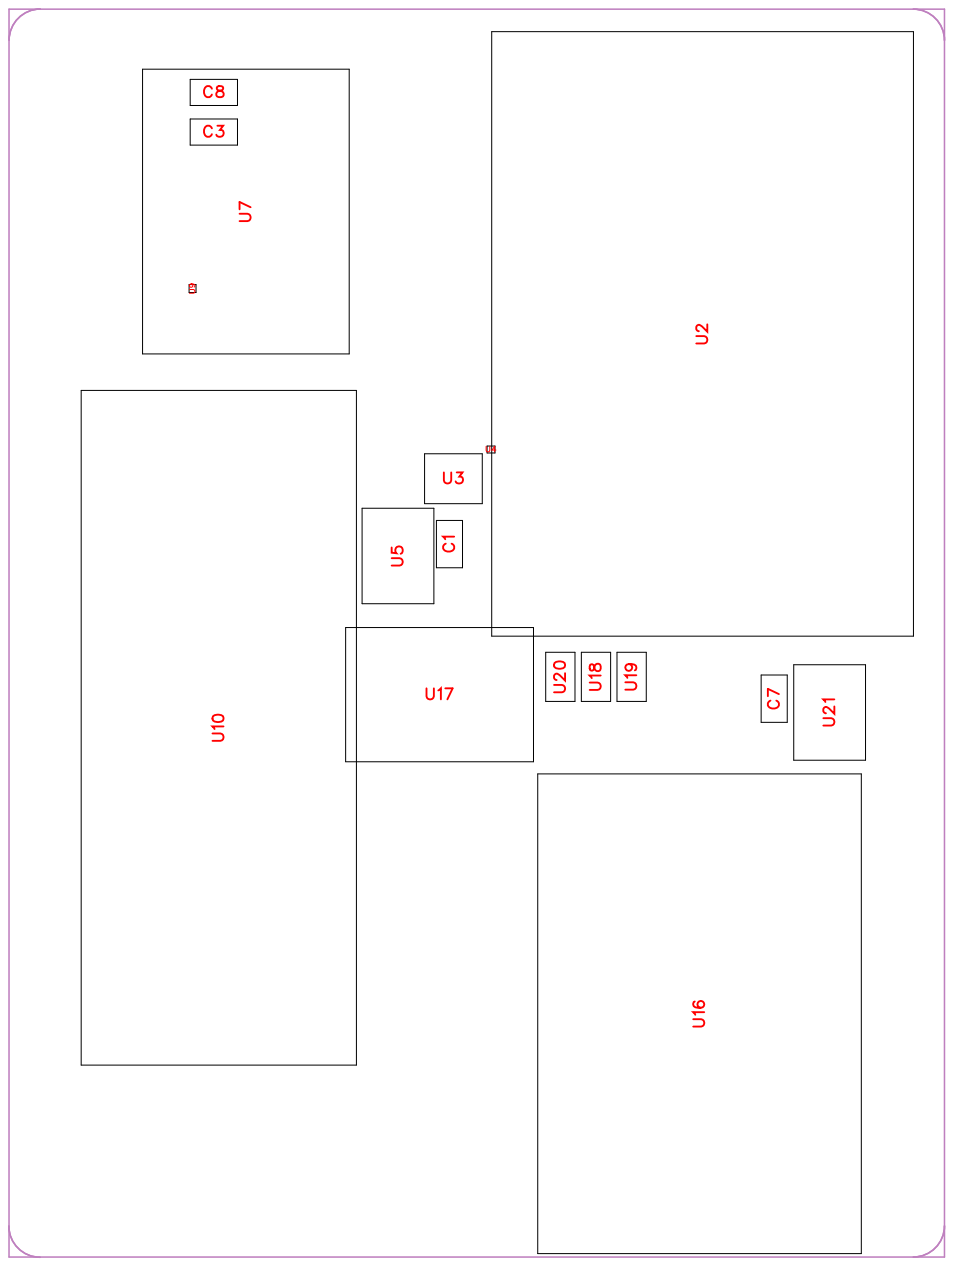
[picture p25: page 2]

No. | Quantity | Comment | Designator | Footprint | Pin Count | Value | Manufacture r Part | Manufacture r | Supplier Part | Supplier | LCSC Price
1 | 9 | 100nF | C1,C2,C3,C4,C5,C6,C7,C8, C9 | C0603 | 2 | 100nF | CGA0603X7R1 04K500JT | HRE(¯ð) | C6119867 | LCSC | 0.0803
2 | 1 | SS54 | D1 | SMA_L4.3-W2 .6-LS5.0-FD | 2 | | SS54 | R+O(• Ú) | C7420369 | LCSC | 0.3038
3 | 1 | DC-005-A200 | DC1 | DC-IN-TH_DC -005-A200 | 3 | | DC-005-A200 | XUNPU(¯n) | C720557 | LCSC | 0.8966
4 | 1 | A254N01-0B1 P51-H25A60 | H1 | HDR-TH_1P-P 2.54-V-M-3 | 1 | | A254N01-0B1 P51-H25A60 | JXTCONN(Ztð) Tj | T* () C41426955 | LCSC | 0.1271
5 | 1 | LAIL-PZ2.54 -2P-W | H2 | HDR-TH_2P-P 2.54-H-M-W1 0.0 | 2 | | LAIL-PZ2.54 -2P-W | LAILAN(±T) | C54950590 | LCSC | 0.1166
6 | 1 | PDC004-PDñ— !W | PD1 | PDC004-PDñ— !W | 2
7 | 1 | ESP32-S3-Pi co | U1 | LCC-40_L51. 0-W21.0-P2. 54-BL_RP204 0-BASED | 40 | | ESP32-S3-Pi co | Waveshare(®) Tj | T* (ê5P) C18198404 | LCSC | 63.15
8 | 1 | E22-900M30S U2 | | WIRELM-SMD_ E22-900M30S | 22 | | E22-900M30S EBYTE(¿py) | | C411294 | LCSC | 44.22
9 | 1 | SN74LVC1G14 DBVR | U3 | SOT-23-5_L3 .0-W1.7-P0. 95-LS2.8-BR | 5 | | SN74LVC1G14 DBVR | UMW(ËðJüS) | C434069 | LCSC | 0.2761
10 | 2 | 22uF | U5,U21 | CAP-SMD_BD4 .0-L4.3-W4. 3-LS5.0-FD | 2 | 22uF | RVT1A220M04 05 22UF 10V | DMBJ(/•s) | C970661 | LCSC | 0.1778
11 | 1 | ATGM336H | U6 | ATGM336H | 5
12 | 1 | GY-BMI160 | U7 | GY-BMI160 | 12
13 | 1 | PCF8563 HW-689 MODULE | U10 | PCF8563-I2C -2.54-1*6 | 6
14 | 1 | GY-BMP280 | U11 | GY-BMP280 | 6
15 | 1 | OLED 0.96 | U13 | OLED 0.96ø | 8
16 | 1 | MP2482 | U16 | MP2482 | 4
17 | 1 | 16V470UF | U17 | CAP-SMD_BD8 .0-L8.3-W8. 3-LS9.3-FD | 2 | | 16V470UF | | C9900014916 LCSC
18 | 3 | 10uf | U18,U19,U20 | CAP-SMD_L2. 0-W1.3-FD | 2 | | 10uf | | C9900016685 LCSC

JLCPCB Price | Name
0.0803 | 100nF
0.304 | SS54
0.897 | DC-005-A200
0.127 | A254N01-0B1 P51-H25A60
0.117 | LAIL-PZ2.54 -2P-W
63.15 | ESP32-S3-Pi co
44.22 | E22-900M30S
0.276 | SN74LVC1G14
| DBVR
0.178 | 22uF

PCF8563
HW-689
MODULE
0.0349 | 16V470UF
0.243 | 10uf

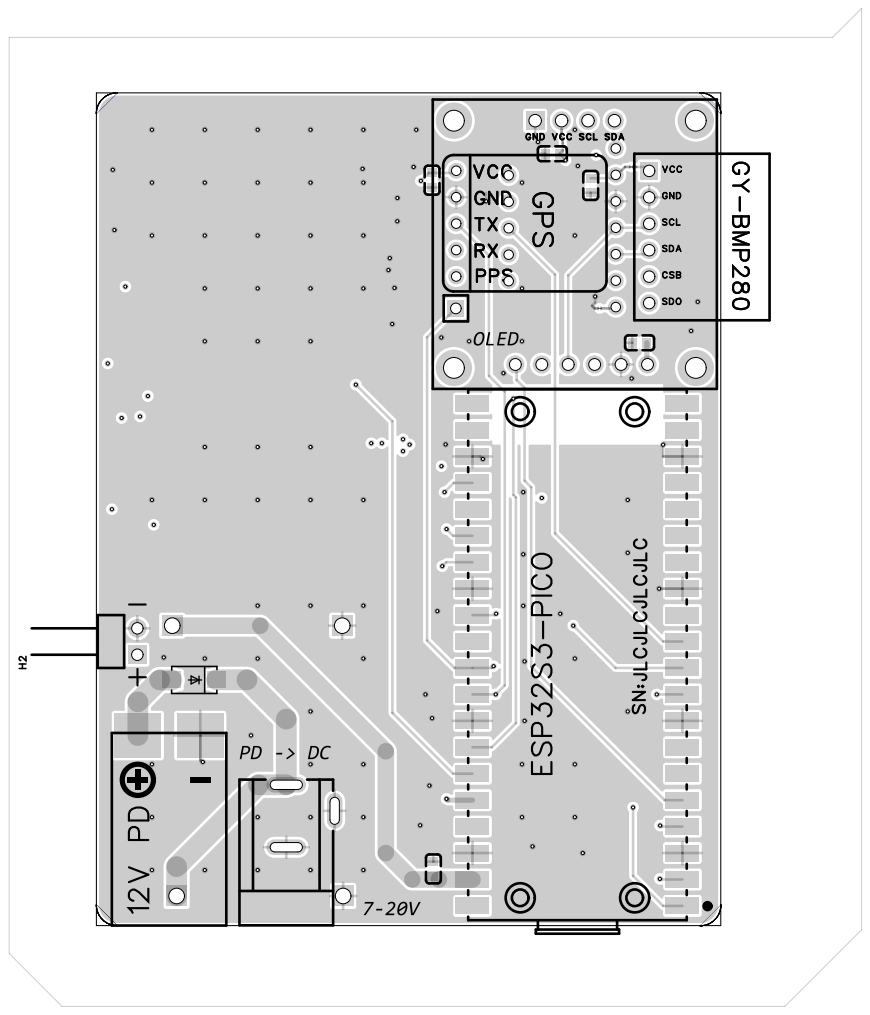
[picture p26: page 5]

GND VCC SCL SDA

VCC GND SCL SDA CSB SDO

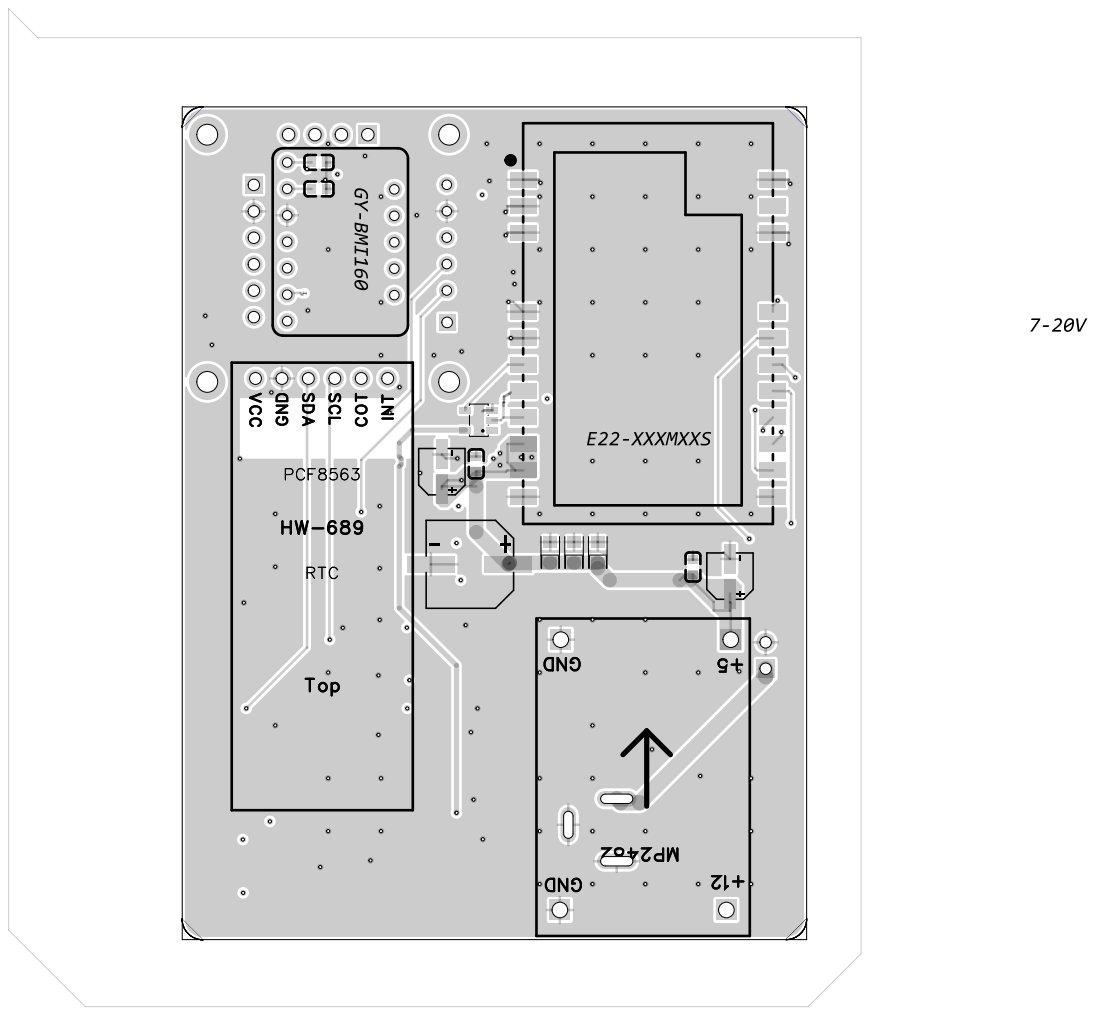
[picture p27: page 6]

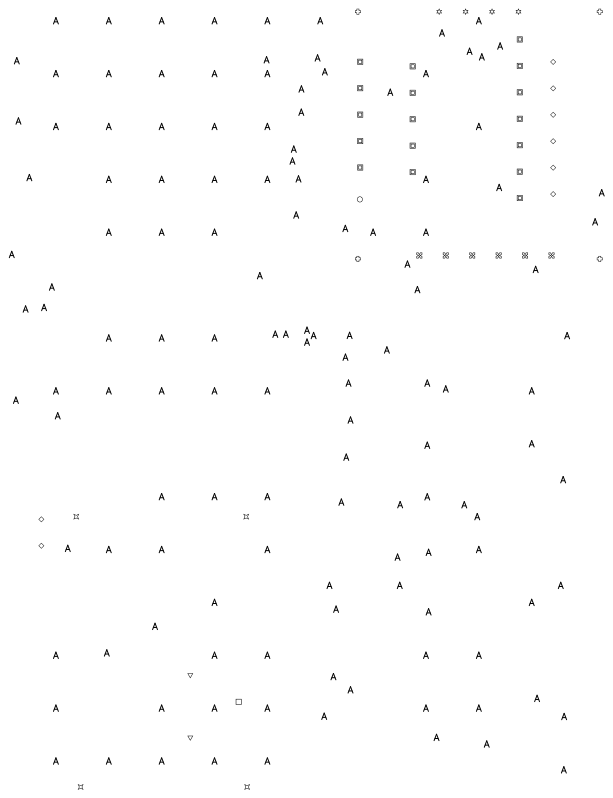
[picture p28: page 7]

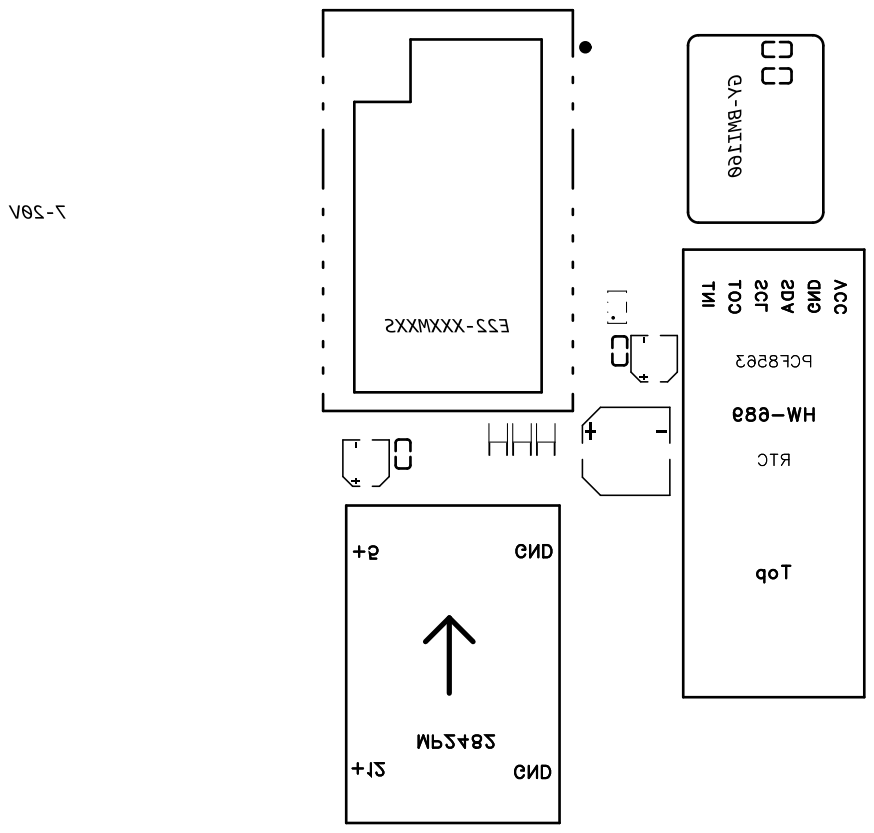
[picture p29: page 8]
