wzqvip/ESP32S3-SX1262-Meshtatics-Station/PCB/PCB_PCB1_1_2026-09-06.pdf

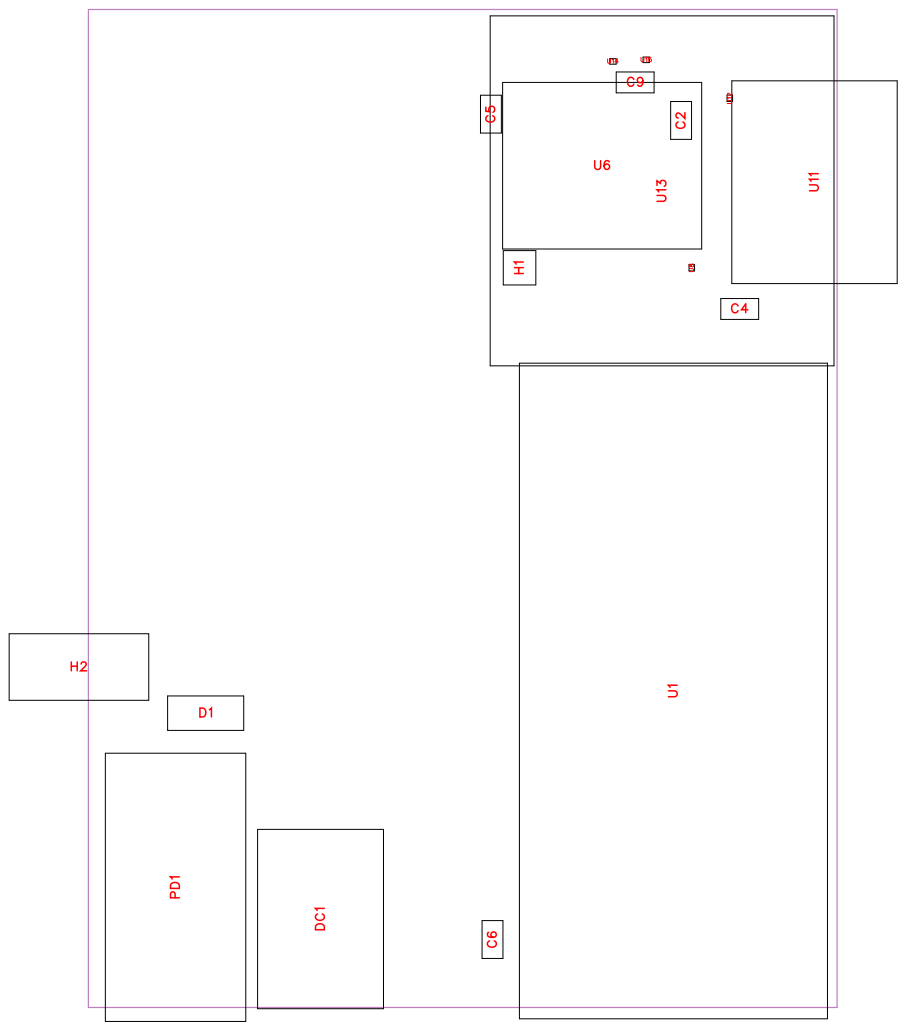
[picture p30: page 1]

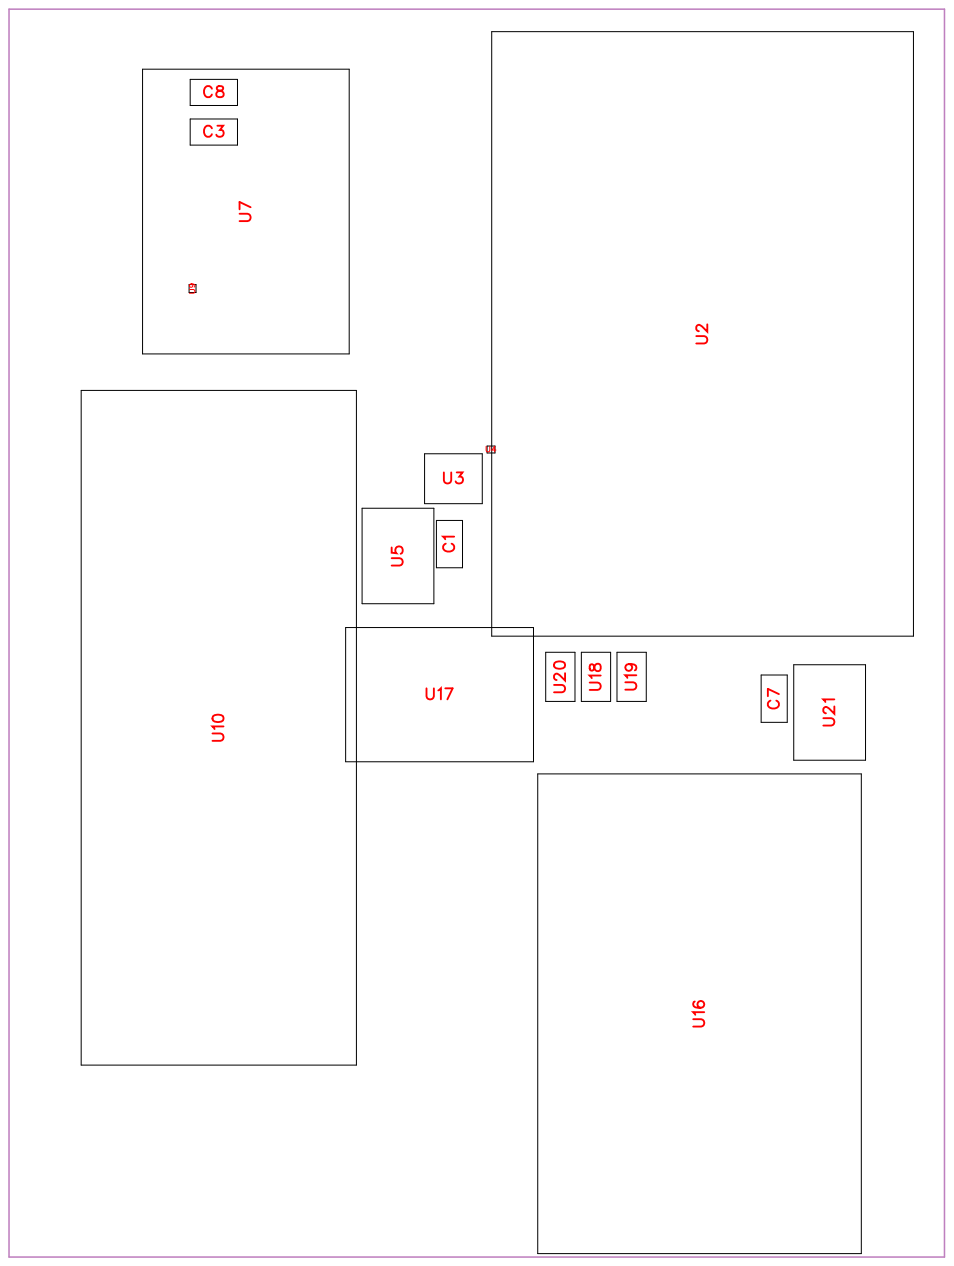
[picture p31: page 2]

No. | Quantity | Comment | Designator | Footprint | Pin Count | Value | Manufacturer Part | Manufacturer | Supplier Part | Supplier | LCSC Price
1 | 9 | 100nF | C1,C2,C3,C4,C5,C6,C7,C8, C9 | C0603 | 2 | 100nF | CGA0603X7 R104K500JT | HRE(芯声) | C6119867 | LCSC | 0.0336
2 | 1 | SS54 | D1 | SMA_L4.3-W 2.6-LS5.0-FD | 2 | | SS54 | R+O(宏嘉诚) | C7420369 | LCSC | 0.2989
3 | 1 | DC-005-A20 0 | DC1 | DC-IN-TH_D C-005-A200 | 3 | | DC-005-A20 0 | XUNPU(讯普 ) | C720557 | LCSC | 0.8831
4 | 1 | A254N01-0B 1P51-H25A6 0 | H1 | HDR-TH_1P-P2.54-V-M-3 | 1 | | A254N01-0B 1P51-H25A6 0 | JXTCONN(聚 兴泰) | C41426955 | LCSC | 0.1271
5 | 1 | LAIL-PZ2.54-2P-W | H2 | HDR-TH_2P-P2.54-H-M-W10.0 | 2 | | LAIL-PZ2.54-2P-W | LAILAN(莱联 ) | C54950590 | LCSC | 0.1166
6 | 1 | PDC004-PD 诱骗模块 | PD1 | PDC004-PD 诱骗模块 | 2
7 | 1 | ESP32-S3-Pi co | U1 | LCC-40_L51. 0-W21.0-P2. 54-BL_RP20 40-BASED | 40 | | ESP32-S3-Pi co | Waveshare( 微雪电子) | C18198404 | LCSC | 63.15
8 | 1 | E22-900M30 S | U2 | WIRELM-SM D_E22-900M 30S | 22 | | E22-900M30 S | EBYTE(亿佰 特) | C411294 | LCSC | 44.22
9 | 1 | SN74LVC1G 14DBVR | U3 | SOT-23-5_L3 .0-W1.7-P0.9 5-LS2.8-BR | 5 | | SN74LVC1G 14DBVR | UMW(友台半 导体) | C434069 | LCSC | 0.2761
10 | 2 | 22uF | U5,U21 | CAP-SMD_B D4.0-L4.3-W 4.3-LS5.0-FD | 2 | 22uF | RVT1A220M 0405 22UF 10V | DMBJ(振宝佳 ) | C970661 | LCSC | 0.1778
11 | 1 | ATGM336H | U6 | ATGM336H | 5
12 | 1 | GY-BMI160 | U7 | GY-BMI160 | 12
13 | 1 | PCF8563 HW-689 MODULE | U10 | PCF8563-I2 C-2.54-1*6 | 6
14 | 1 | GY-BMP280 | U11 | GY-BMP280 | 6
15 | 1 | OLED 0.96 | U13 | OLED 0.96寸 | 8
16 | 1 | MP2482 | U16 | MP2482 | 4
17 | 1 | 16V470UF | U17 | CAP-SMD_B D8.0-L8.3-W 8.3-LS9.3-FD | 2 | | 16V470UF | | C990001491 6 | LCSC
18 | 3 | 10uf | U18,U19,U20 | CAP-SMD_L 2.0-W1.3-FD | 2 | | 10uf | | C990001668 5 | LCSC

JLCPCB Price | Name
0.0336 | 100nF
0.299 | SS54
0.883 | DC-005-A20 0
0.127 | A254N01-0B 1P51-H25A6 0
0.117 | LAIL-PZ2.54-2P-W
63.15 | ESP32-S3-Pi co
44.22 | E22-900M30 S
0.276 | SN74LVC1G 14DBVR
0.178 | 22uF

PCF8563
HW-689
MODULE
0.0349 | 16V470UF
0.243 | 10uf

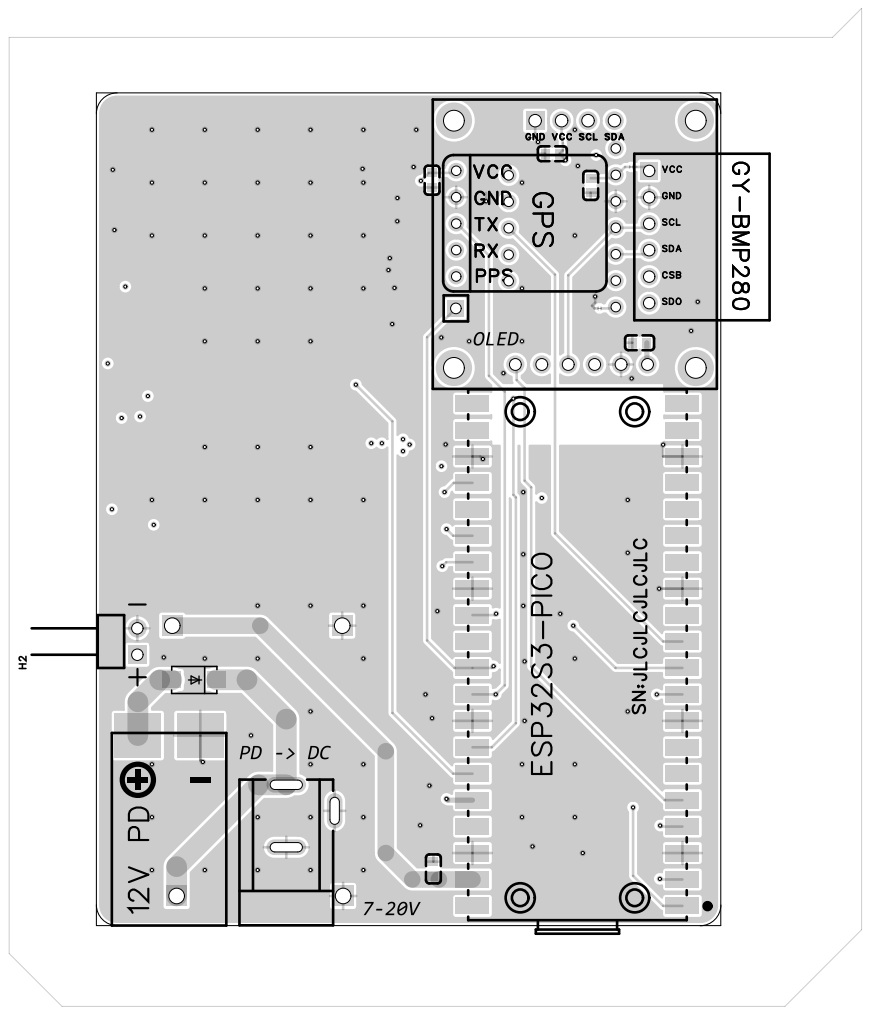
[picture p32: page 5]

GND VCC SCL SDA

VCC GND SCL SDA CSB SDO

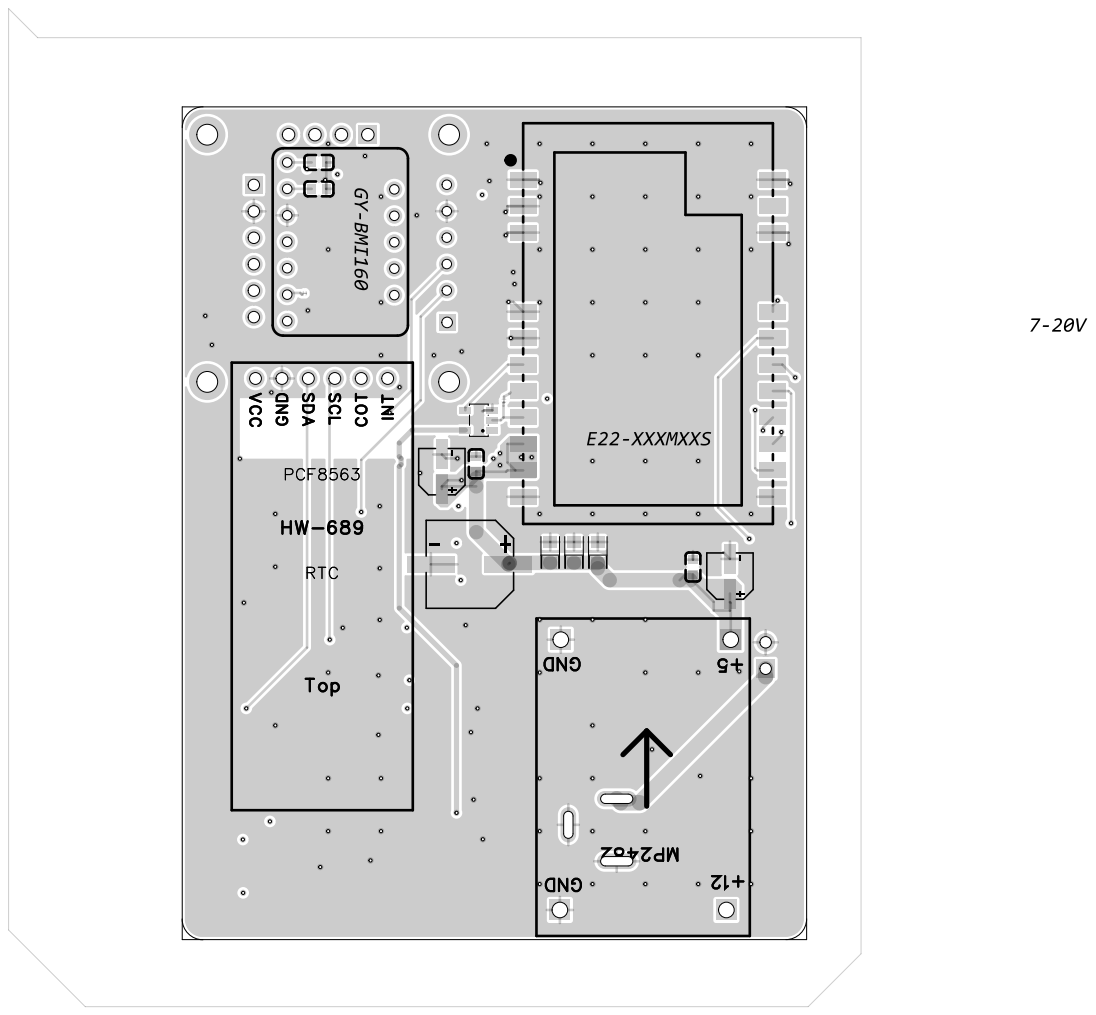
[picture p33: page 6]

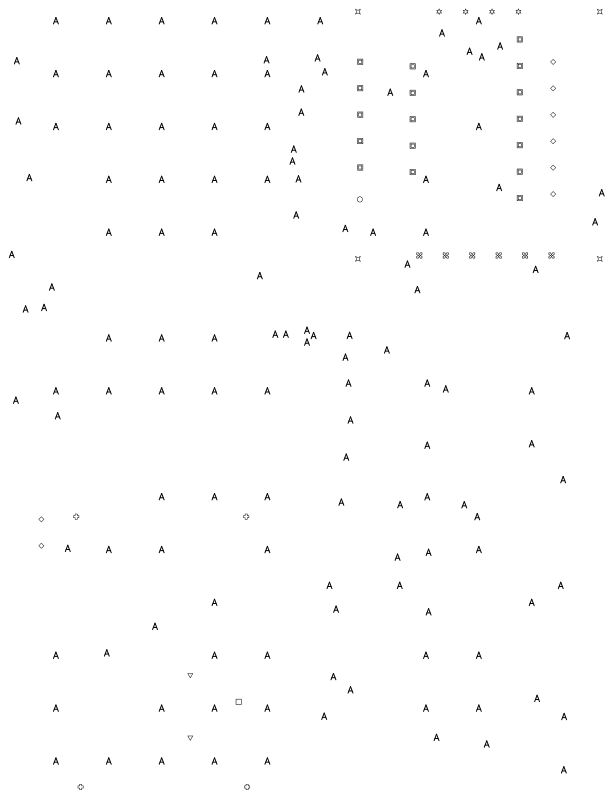
[picture p34: page 7]
