wzqvip/ESP32S3-SX1262-Meshtatics-Station/Review/meshtastic-variant/upstream-modified/configuration.h

#pragma once
#include <Arduino.h>
#if __has_include("Melopero_RV3028.h")
#include "Melopero_RV3028.h"
#endif
#if __has_include(<PCF8xRTC.h>)
#include <PCF8xRTC.h>
#endif
#include "variant.h"
#if defined(PCF8563_RTC)
#define PCF_RTC_ADDRESS PCF8563_RTC
#define PCF_RTC_CHIP PCF8xRTC::PCF8563
#elif defined(PCF85063_RTC)
#define PCF_RTC_ADDRESS PCF85063_RTC
#define PCF_RTC_CHIP PCF8xRTC::PCF85063
#endif
#define MESHTASTIC_USE_EINK_UI 0
#if MESHTASTIC_USE_EINK_UI
#define USE_EINK
#else
#undef USE_EINK
#endif
#ifndef APP_VERSION
#error APP_VERSION must be set by the build environment
#endif
#define HW_VERSION "1.0"
#define MESHTASTIC_PREHOP_DROP 1
#define MESHTASTIC_TRIG_APPROX 1
#define MESHTASTIC_ENABLE_FRAME_INJECTION 0
#define xstr(s) ystr(s)
#define ystr(s) #s
#define optstr(s) (xstr(s)[0] ? xstr(s) : "unset")
#define EXT_RAM_ATTR
#define IRAM_ATTR
#define RTC_DATA_ATTR
#define EXT_RAM_BSS_ATTR EXT_RAM_ATTR
#ifdef EBYTE_E22_900M30S
#define TX_GAIN_LORA 7
#define SX126X_MAX_POWER 22
#endif
#ifdef EBYTE_E22_900M33S
#define TX_GAIN_LORA 25
#define SX126X_MAX_POWER 8
#endif
#if defined(TMESH_S3_E22) && defined(TMESH_LOW_POWER_TEST)
#if defined(EBYTE_E22_900M33S)
#undef SX126X_MAX_POWER
#define SX126X_MAX_POWER 25
#elif defined(EBYTE_E22_900M30S)
#undef SX126X_MAX_POWER
#define SX126X_MAX_POWER 15
#endif
#endif
#ifdef NICERF_MINIF27
#define TX_GAIN_LORA 7
#define SX126X_MAX_POWER 22
#endif
#ifdef NICERF_F30_HF
#define TX_GAIN_LORA 8
#define SX126X_MAX_POWER 22
#endif
#ifdef NICERF_F30_LF
#define TX_GAIN_LORA 10
#define SX126X_MAX_POWER 22
#endif
#ifdef USE_GC1109_PA
#define NUM_PA_POINTS 22
#define TX_GAIN_LORA 11, 11, 11, 11, 11, 11, 11, 11, 11, 11, 11, 11, 11, 11, 11, 11, 10, 10, 9, 9, 8, 7
#endif
#ifdef USE_KCT8103L_PA
#if defined(HELTEC_WIRELESS_TRACKER_V2)
#define NUM_PA_POINTS 22
#define TX_GAIN_LORA 14, 14, 14, 14, 14, 14, 14, 14, 14, 14, 14, 14, 13, 13, 13, 12, 12, 11, 10, 9, 8, 7
#elif defined(HELTEC_MESH_NODE_T096)
#define NUM_PA_POINTS 22
#define TX_GAIN_LORA 14, 14, 14, 14, 14, 14, 14, 14, 14, 14, 14, 14, 14, 13, 13, 13, 12, 11, 10, 9, 8, 7
#elif defined(HELTEC_V4_R8)
#define NUM_PA_POINTS 22
#define TX_GAIN_LORA 13, 13, 13, 13, 13, 13, 13, 13, 13, 13, 13, 13, 13, 13, 12, 12, 11, 11, 10, 9, 8, 7
#else
#if !defined(NUM_PA_POINTS) || !defined(TX_GAIN_LORA)
#error "USE_KCT8103L_PA is defined, but no PA gain curve (NUM_PA_POINTS / TX_GAIN_LORA) is configured for this board."
#endif
#endif
#endif
#ifdef USE_KCT8103L_PA_ONLY
#if defined(HELTEC_MESH_TOWER_V2)
#define NUM_PA_POINTS 22
#define TX_GAIN_LORA 11, 11, 11, 11, 11, 11, 11, 11, 11, 11, 10, 10, 10, 10, 10, 10, 10, 10, 10, 9, 8, 7
#endif
#endif
#ifdef RAK13302
#define NUM_PA_POINTS 22
#define TX_GAIN_LORA 7, 8, 8, 8, 8, 8, 9, 9, 9, 9, 9, 9, 9, 9, 9, 9, 9, 9, 9, 9, 9, 8
#endif
#ifdef SEEED_WIO_TRACKER_L1_PRO_1W
#define NUM_PA_POINTS 22
#define TX_GAIN_LORA 10, 10, 10, 10, 10, 10, 10, 10, 10, 11, 11, 11, 11, 11, 11, 11, 11, 11, 11, 11, 10, 10
#endif
#ifndef NUM_PA_POINTS
#define NUM_PA_POINTS 1
#endif
#ifndef TX_GAIN_LORA
#define TX_GAIN_LORA 0
#endif
#define HAS_LORA_FEM 0
#define SSD1306_ADDRESS_L 0x3C // Addr = 0
#define SSD1306_ADDRESS_H 0x3D // Addr = 1
#if (defined(SEEED_WIO_TRACKER_L1) || defined(SEEED_WIO_TRACKER_L1_PRO_1W)) && !defined(SEEED_WIO_TRACKER_L1_EINK)
#define SSD1306_ADDRESS SSD1306_ADDRESS_H
#define USE_SH1106
#endif
#define ST7567_ADDRESS 0x3F
#define CARDKB_ADDR 0x5F
#define TDECK_KB_ADDR 0x55
#define BBQ10_KB_ADDR 0x1F
#define MPR121_KB_ADDR 0x5A
#define TCA8418_KB_ADDR 0x34
#define TSTC8_KB_V1_ADDR 0x6C // STC8H companion-MCU keypad on the ThinkNode-M9 V1
#define TSTC8_KB_V2_ADDR 0x6D // STC8H companion-MCU keypad on the ThinkNode-M9 V2
#define BME_ADDR 0x76
#define BME_ADDR_ALTERNATE 0x77
#define MCP9808_ADDR 0x18
#define INA_ADDR 0x40 // same as SHT2X
#define INA_ADDR_ALTERNATE 0x41
#define INA_ADDR_WAVESHARE_UPS 0x43
#define INA3221_ADDR 0x42
#define MAX1704X_ADDR 0x36
#define QMC6310U_ADDR 0x1C
#define QMI8658_ADDR 0x6B
#define QMC5883L_ADDR 0x0D
#define HMC5883L_ADDR 0x1E
#define MMC5983MA_ADDR 0x30
#define QMC6309_ADDR 0x7C
#define SHTC3_ADDR 0x70
#define LPS22HB_ADDR 0x5C
#define LPS22HB_ADDR_ALT 0x5D
#define SFA30_ADDR 0x5D
#define SHTXX_ADDR 0x44
#define SHTXX_ADDR_ALT 0x45
#define PMSA003I_ADDR 0x12
#define QMA6100P_ADDR 0x12
#define AHT10_ADDR 0x38
#define RCWL9620_ADDR 0x57
#define VEML7700_ADDR 0x10
#define TSL25911_ADDR 0x29
#define OPT3001_ADDR 0x45
#define OPT3001_ADDR_ALT 0x44
#define MLX90632_ADDR 0x3A
#define DFROBOT_LARK_ADDR 0x42
#define DFROBOT_RAIN_ADDR 0x1d
#define NAU7802_ADDR 0x2A
#define MAX30102_ADDR 0x57
#define SCD4X_ADDR 0x62
#define CW2015_ADDR 0x62
#define MLX90614_ADDR_DEF 0x5A
#define CGRADSENS_ADDR 0x66
#define LTR390UV_ADDR 0x53
#define XPOWERS_AXP192_AXP2101_ADDRESS 0x34 // same adress as TCA8418_KB
#define PCT2075_ADDR 0x37
#define BQ27220_ADDR 0x55 // same address as TDECK_KB
#define BQ25896_ADDR 0x6B
#define LTR553ALS_ADDR 0x23
#define SEN5X_ADDR 0x69
#define SEN6X_ADDR 0x6B // same as QMI8658_ADDR and BQ25896_ADDR
#define SCD30_ADDR 0x61
#define ADS1X15_ADDR 0x48
#define ADS1X15_ADDR_ALT1 0x49
#define ADS1X15_ADDR_ALT2 0x4A
#define ADS1X15_ADDR_ALT3 0x4B
#define DS248X_ADDR 0x18      // same as MCP9808_ADDR, STK8BXX_ADDR and LIS3DH_ADDR
#define DS248X_ADDR_ALT1 0x19 // same as LIS3DH_ADDR_ALT and BMA423_ADDR
#define DS248X_ADDR_ALT2 0x1A // same as CST328_ADDR
#define DS248X_ADDR_ALT3 0x1B
#define DS248X_ADDR_ALT4 0x1C // same as QMC6310U_ADDR
#define DS248X_ADDR_ALT5 0x1D // same as DFROBOT_RAIN_ADDR
#define DS248X_ADDR_ALT6 0x1E // same as HMC5883L_ADDR
#define DS248X_ADDR_ALT7 0x1F // same as BBQ10_KB_ADDR
#define HM330X_ADDR 0x40
#define AS3935_ADDR 0x03 // both address pins tied high, the common breakout-board default
#define AS3935_ADDR_ALT 0x01
#define AS3935_ADDR_ALT2 0x02
#define MPU6050_ADDR 0x68
#define STK8BXX_ADDR 0x18
#define LIS3DH_ADDR 0x18
#define LIS3DH_ADDR_ALT 0x19
#define BMA423_ADDR 0x19
#define LSM6DS3_ADDR 0x6A
#define BMX160_ADDR 0x69
#define ICM20948_ADDR 0x69
#define ICM20948_ADDR_ALT 0x68
#define BHI260AP_ADDR 0x28
#define BMM150_ADDR 0x13
#define DA217_ADDR 0x26
#define BMI270_ADDR 0x68
#define BMI270_ADDR_ALT 0x69
#define ICM42607P_ADDR 0x68
#define ICM42607P_ADDR_ALT 0x69
#define NCP5623_ADDR 0x38
#define LP5562_ADDR 0x30
#define LP5814_ADDR 0x2C
#if not __has_include("Codecs/es8311/ES8311.h")
#define ES8311_ADDR 0x18 // same address as MCP9808_ADDR / STK8BXX_ADDR / LIS3DH_ADDR
#endif
#define ES7243E_ADDR 0x14
#define TCA9535_ADDR 0x20
#define TCA9555_ADDR 0x26
#define FT6336U_ADDR 0x48 // same address as ADS1115
#define CST328_ADDR 0x1A  // same address as CST226SE
#define CHSC6X_ADDR 0x2E
#define CST226SE_ADDR_ALT 0x5A
#define GT911_ADDR 0x5D // same address as SFA30_ADDR / LPS22HB_ADDR_ALT
#define RAK120351_ADDR 0x20
#define RAK120352_ADDR 0x21
#define RAK120353_ADDR 0x22
#define TPS65233_ADDR 0x60
#define COLOR565(r, g, b) (((r & 0xF8) << 8) | ((g & 0xFC) << 3) | ((b & 0xF8) >> 3))
#if defined(VEXT_ENABLE) && !defined(VEXT_ON_VALUE)
#define VEXT_ON_VALUE LOW
#endif
#define ROTARY_DELAY 5
#define GPS_BAUDRATE 9600
#define GPS_BAUDRATE_FIXED 0
#define GPS_THREAD_INTERVAL 200
#include "architecture.h"
#define DEFAULT_REBOOT_SECONDS 7
#define DEFAULT_SHUTDOWN_SECONDS 2
#define MINIMUM_SAFE_FREE_HEAP 1500
#if defined(I2C_SDA1) || defined(PIN_WIRE1_SDA) || defined(SENSECAP_INDICATOR)
#define WIRE_INTERFACES_COUNT 2
#elif HAS_WIRE
#define WIRE_INTERFACES_COUNT 1
#endif
#define HAS_WIFI 0
#define HAS_ETHERNET 0
#if (defined(USE_WS5500) || defined(USE_CH390D)) && !HAS_ETHERNET
#error "USE_WS5500 and USE_CH390D require HAS_ETHERNET"
#endif
#define HAS_SCREEN 0
#define HAS_TFT 0
#define BASEUI_HAS_GAMES 0
#define HAS_WIRE 0
#define HAS_GPS 0
#define HAS_BUTTON 0
#define HAS_TRACKBALL 0
#define HAS_TOUCHSCREEN 0
#define HAS_TELEMETRY 0
#define HAS_SENSOR 0
#define HAS_RADIO 0
#define HAS_CPU_SHUTDOWN 0
#define HAS_BLUETOOTH 0
#define USE_TFTDISPLAY 0
#ifndef HW_VENDOR
#error HW_VENDOR must be defined
#endif
#define TB_DOWN 255
#define TB_UP 255
#define TB_LEFT 255
#define TB_RIGHT 255
#define TB_PRESS 255
#if defined(HAS_NCP5623) || defined(HAS_LP5562) || defined(RGBLED_RED) || defined(HAS_NEOPIXEL) || defined(UNPHONE)
#define HAS_RGB_LED
#endif
#define LED_STATE_ON 1
#define LED_STATE_OFF (LED_STATE_ON ^ 1)
#define ledOff(pin) pinMode(pin, INPUT)
#if defined(PIN_BUTTON2) && !defined(CANCEL_BUTTON_PIN)
#define ALT_BUTTON_PIN PIN_BUTTON2
#endif
#if defined ALT_BUTTON_PIN
#define ALT_BUTTON_ACTIVE_LOW true
#define ALT_BUTTON_ACTIVE_PULLUP true
#endif
#if !defined(ARCH_ESP32) && !defined(ARCH_PORTDUINO) && !defined(MESHTASTIC_EXCLUDE_STOREFORWARD)
#define MESHTASTIC_EXCLUDE_STOREFORWARD 1
#endif
#define HAS_NETWORKING (HAS_WIFI || HAS_ETHERNET)
#if !MESHTASTIC_EXCLUDE_I2C
#if defined(BMA4XX_INT) && defined(HAS_BMA423)
#define MOTION_WAKE_INT_PIN BMA4XX_INT
#define MOTION_WAKE_INT_ACTIVE_HIGH 1
#elif defined(BHI260AP_INT) && defined(HAS_BHI260AP)
#define MOTION_WAKE_INT_PIN BHI260AP_INT
#define MOTION_WAKE_INT_ACTIVE_HIGH 1
#elif defined(STK8XXX_INT) && defined(HAS_STK8XXX)
#define MOTION_WAKE_INT_PIN STK8XXX_INT
#define MOTION_WAKE_INT_ACTIVE_HIGH 1
#elif defined(ICM_20948_INT_PIN) && defined(HAS_ICM20948)
#define MOTION_WAKE_INT_PIN ICM_20948_INT_PIN
#define MOTION_WAKE_INT_ACTIVE_HIGH 0
#elif defined(QMA_6100P_INT_PIN) && defined(HAS_QMA6100P)
#define MOTION_WAKE_INT_PIN QMA_6100P_INT_PIN
#define MOTION_WAKE_INT_ACTIVE_HIGH 0
#endif
#endif
#define USE_ETHERNET_DEFAULT 0
#if defined(ARCH_NRF52)
#define MESHTASTIC_ENABLE_LOCKDOWN 0
#if !MESHTASTIC_ENABLE_LOCKDOWN
#undef MESHTASTIC_LOCKDOWN
#undef MESHTASTIC_PHONEAPI_ACCESS_CONTROL
#undef MESHTASTIC_ENCRYPTED_STORAGE
#undef MESHTASTIC_ENABLE_APPROTECT
#define MESHTASTIC_EXCLUDE_LOCKDOWN 1
#endif
#if MESHTASTIC_ENABLE_LOCKDOWN && !defined(MESHTASTIC_EXCLUDE_LOCKDOWN)
#define MESHTASTIC_LOCKDOWN 1
#define MESHTASTIC_PHONEAPI_ACCESS_CONTROL 1
#define MESHTASTIC_ENCRYPTED_STORAGE 1
#ifndef MESHTASTIC_LOCKDOWN_DEBUG
#define MESHTASTIC_ENABLE_APPROTECT 1
#endif
#endif
#endif
#ifdef MESHTASTIC_LOCKDOWN
#define MESHTASTIC_LOCKDOWN_SESSION_DEFAULT_SECONDS 0
#endif // MESHTASTIC_LOCKDOWN
#include "DebugConfiguration.h"
#include "RF95Configuration.h"
