wzqvip/ESP32S3-SX1262-Meshtatics-Station/(commit log)

2026-10-15 Organize repo: docs, tools, remove duplicate patch copies
    - Add Review/UPSTREAM-CONTRIBUTION.md: how to fork meshtastic/firmware,
    what belongs upstream vs. what stays here, and the CLA requirement
    - README: add a verified-build section with the board-specific gotchas
    (RF switch, 33S power table, PSRAM, GPS pins, RTC) and a doc index
    - FEATURES-AND-LIMITS: BMI160 is now supported by the in-repo driver
    - Move ad-hoc serial helper scripts to tools/ with readable names
    - Remove Review/meshtastic-variant/patches/ (byte-identical duplicate of
    upstream-modified/, which is the canonical reference copy)
    - Track the extracted E22-900M30S datasheet text for grep-ability
    Two long docs' worth of c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
2026-10-15 Verify upstream has no BMI160; correct contribution guide
    Checked four independent ways (2026-10-15), all agree:
    - develop:src/motion/BMI160Sensor.{h,cpp} -> HTTP 404
    - develop copies of the four target files -> 0 hits for BMI160
    - /search/issues?q=BMI160+repo:meshtastic/firmware -> total_count 0
    - /contents/src/motion -> BMI270/BMX160/BMM150/BMA423/BHI260AP only
    Two corrections to the guide, both found while verifying:
    1. The default branch is develop, not master. PRs must target develop;
    master is the release branch. Fixed branch commands and the checklist.
    2. My build baseline (04cb888) is 8 commits behind develop (bda9f8c).
    Of the four files the driver touches, upstream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
2026-10-15 Add photographs of the assembled board
    Three photos under Photos/, linked from a new README section:
    01-assembled-board-running board powered, with inline meters on the 12 V
    feed and on the board itself. Idle draw is
    about 78 mW (17.2 mA at 4.56 V).
    02-oled-lora-screen the default LoRa frame: BLE MAC, role, region
    and preset, frequency, channel utilisation.
    03-enclosure-inside the radio, buck stage and I2C modules inside
    the printed case.
    The two OLED shots predate the button support and the finished module set,
    so they show 1/1 frames, the LongTurb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
2026-10-15 Record the int16 overflow CodeRabbit found in the motion delta
    The delta was computed as 'int16_t deltaX = abs(x - prevX)'. Both samples are
    int16_t, so the difference is truncated on assignment: -32768 to 32767 is
    65535, which wraps to -1, and abs() then yields 1. The largest possible
    movement was therefore the one case the threshold test was guaranteed to
    miss. Fixed in the PR by widening to int32_t.
    Also notes that BMI270Sensor.cpp carries the same pattern upstream. That file
    is out of scope for a PR that adds a driver, but it is a pre-existing bug
    worth its own report, so record it here rather than quietly fixing it inside
    an unrelated change.
    Corrects the change list: the PR carries s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
2026-10-15 Correct the radio model in the hardware docs
    Several documents still described this board as carrying an E22-900M30S
    (1 W, ~650 mA). The board actually has an E22-900M33S (2 W, ~1200 mA); the
    30S references are leftovers from before that was established, and some were
    self-contradictory. MESHTASTIC-VARIANT.md said 'the board is a 30S' in one
    line and 'a 33S is not a drop-in replacement' a few lines later.
    Corrected in README, board_tmesh.h, FLASHING.md, HARDWARE-REVIEW.md,
    MESHTASTIC-VARIANT.md, NANO-G1-VS-THIS-BOARD.md, CURRENT-STATUS.md and the
    variant's platformio.ini/variant.h. Where 30S figures remain they now appear
    only as an explicit contrast, since the two modules are pin-compatibl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
