wzqvip/ESP32S3-SX1262-Meshtatics-Station/(notices)

Notices in the files:
Review/meshtastic-variant/upstream-modified/configuration.h:
Copyright (C) 2018 by Xose Pérez <xose dot perez at gmail dot com>
This program is free software: you can redistribute it and/or modify
it under the terms of the GNU General Public License as published by
the Free Software Foundation, either version 3 of the License, or
(at your option) any later version.
